google/zimu/firmware/imu2_filtered/README.md

MIMU Firmware
=============

These files contain the source for the TMS320F28335 processor on the MIMU board. This has been tested using Texas Instruments Code Composer Studio v5, and requires DSP/Bios 5.4x.
