google/zimu/hardware/IMU_v2_side/imu_v2_side_SC_BOM.xls

Sample Bill of Materials (BOM) - Customer Provides Materials
Item # | Qty | Ref Des | Part No. | Description | Package | Type | Vendor | status
1 | 1 | C14 | 445-1311-1-ND | 0.01UF | 0603 | SMT | Digikey | 20
2 | 6 | C1, C2, C3, C7, C8, C13 | 490-1519-1-ND | 0.1UF | 0603 | SMT | Digikey | 100
3 | 2 | C4, C6 | 399-1280-1-ND (http://search.digikey.com/scripts/DkSearch/dksus.dll?Detail&itemSeq=105548842&uq=634534378129228834) | 0.022UF | 0603 | SMT | Digikey | 30
4 | 3 | C9, C10, C11 | 490-3290-1-ND | 0.22UF | 0603 | SMT | Digikey | 40
5 | 1 | C5 | 478-1232-1-ND (http://search.digikey.com/scripts/DkSearch/dksus.dll?Detail&itemSeq=105548793&uq=634534378129228834) | 0.027UF | 0603 | SMT | Digikey | 20
6 | 1 | C12 | 587-1253-1-ND | 2.2UF | 0603 | SMT | Digikey | 20
7 | 2 | R8, R9 | TNP4.99KAACT-ND | 4.99K | 0603 | SMT | Digikey | 30
8 | 4 | R2, R3, R5, R7 | P10.0KHCT-ND | 10K | 0603 | SMT | Digikey | 60
9 | 1 | R1 | P226KHCT-ND | 226K | 0603 | SMT | Digikey | 20
10 | 1 | U3 | 1221L-050 | ACCEL_1221 | LCC-20 | BGA | Silicon Designs | 13
11 | 1 | U1 | ADXRS642BBG | ADXRS642BBZG | CBGA32 | BGA | Arrow | 13
12 | 2 | R4, R6 |  | DNL | 0603 | DNS
13 | 1 | S1 |  | HEADER_1X12_IMU |  | DNS
14 | 1 | U2 | 342-1055-1-ND | HMC6042 | LCC-20 | BGA | Digikey | 25
15 | 4 | E1, E2, E3, E4 |  | TP40RND |  | DNS
 |  |  |  | BOARD SUMMARY FOR QUOTE
 |  |  |  | Total # of unique parts | 12
 |  |  |  | SMT placements per board | 21
 |  |  |  | Thru-hole placements per board | 0
 |  |  |  | Fine pitch placements per board | 0
 |  |  |  | BGA placements per board | 3
Screaming Circuits |  |  | Toll-free 866-784-5887 |  |  | 1140 NW Third Ave.
www.ScreamingCircuits.com |  |  | Fax 503-263-9101
A Division of Milwaukee Electronics Inc. |  |  | Email: sales@screamingcircuits.com |  |  | Canby, OR 97013
