google/zimu/hardware/IMU_v2/imu_v2_SC_BOM.xls

Sample Bill of Materials (BOM) - Customer Provides Materials
Item # | Qty | Ref Des | Part No. | Description | Package | Type | Vender | status
1 | 1 | R71 | P0.0GCT-ND | 0 | 0603 | SMT | Digikey | 50
2 | 7 | C29, C77, C113, C117, C122, C127, C131 | 445-1311-1-ND | 0.01UF | 0603 | SMT | Digikey | 50
3 | 53 | C1, C2, C3, C4, C5, C6, C7, C8, C9, C10, C11, C12, C13, C14, C15, C16, C17, C18, C19, C20, C21, C22, C23, C24, C25, C26, C27, C28, C30, C31, C32, C43, C44, C55, C56, C57, C58, C59, C65, C66, C67, C68, C71, C73, C79, C80, C85, C96, C101, C102, C103, C112, C133 | 490-1519-1-ND | 0.1UF | 0603 | SMT | Digikey | 350
4 | 2 | C60, C64 | 399-1280-1-ND (http://search.digikey.com/scripts/DkSearch/dksus.dll?Detail&itemSeq=105548842&uq=634534378129228834) | 0.022UF | 0603 | SMT | Digikey | 20
5 | 12 | C63, C72, C75, C86, C87, C89, C91, C98, C100, C105, C107, C109 | 490-3290-1-ND | 0.22UF | 0603 | SMT | Digikey | 80
6 | 1 | C61 | 478-1232-1-ND (http://search.digikey.com/scripts/DkSearch/dksus.dll?Detail&itemSeq=105548793&uq=634534378129228834) | 0.027UF | 0603 | SMT | Digikey | 10
7 | 9 | C62, C74, C88, C90, C97, C99, C104, C106, C108 | 490-3291-1-ND | 0.47UF | 0603 | SMT | Digikey | 60
8 | 1 | R70 | P1.78KHCT-ND | 1.78K | 0603 | SMT | Digikey | 10
9 | 3 | R9, R10, R69 | P1.00KHCT-ND | 1K | 0603 | SMT | Digikey | 50
10 | 10 | C70, C78, C83, C84, C94, C95, C116, C121, C126, C130 | 490-3897-1-ND | 1UF | 0603 | SMT | Digikey | 70
11 | 2 | C53, C54 | 587-1253-1-ND | 2.2UF | 0603 | SMT | Digikey | 20
12 | 1 | L1 | 445-3215-1-ND | 2.2UH |  | SMT | Digikey | 10
13 | 1 | R68 | P2.80KHCT-ND | 2.8K | 0603 | SMT | Digikey | 10
14 | 2 | R3, R4 | P2.21KHCT-ND | 2.21K | 0603 | SMT | Digikey | 20
15 | 3 | R30, R43, R44 | P2.00KHCT-ND | 2K | 0603 | SMT | Digikey | 20
16 | 1 | L2 | 445-3216-1-ND | 3.3UH |  | SMT | Digikey | 10
17 | 2 | R1, R2 | P4.64KHCT-ND | 4.64K | 0603 | SMT | Digikey | 20
18 | 6 | R14, R47, R49, R53, R55, R57 | P4.87KHCT-ND | 4.87K | 0603 | SMT | Digikey | 50
19 | 4 | R20, R21, R28, R29 | TNP4.99KAACT-ND | 4.99K | 0603 | SMT | Digikey | 30
20 | 6 | R22, R26, R31, R32, R39, R40 | P5.36KHCT-ND | 5.36K | 0603 | SMT | Digikey | 50
21 | 3 | R27, R41, R42 | P6.98KHCT-ND | 6.98K | 0603 | SMT | Digikey | 50
22 | 9 | R15, R25, R35, R38, R48, R50, R54, R56, R58 | P9.53KHCT-ND | 9.53K | 0603 | SMT | Digikey | 100
23 | 5 | R8, R18, R19, R59, R62 | P10.0KHCT-ND | 10K | 0603 | SMT | Digikey | 50
24 | 4 | C120, C124, C125, C129 | 587-1353-1-ND | 10UF | 1201 | SMT | Digikey | 30
25 | 3 | R13, R45, R46 | P12.0KHCT-ND | 12K | 0603 | SMT | Digikey | 50
26 | 1 | R61 | P14.7KHCT-ND | 14.7K | 0603 | SMT | Digikey | 10
27 | 3 | R24, R34, R37 | P16.2KHCT-ND | 16.2K | 0603 | SMT | Digikey | 50
28 | 2 | C33, C34 | 490-1408-1-ND | 16PF | 0603 | SMT | Digikey | 20
29 | 4 | R17, R51, R52, R67 | P20.0KHCT-ND | 20K | 0603 | SMT | Digikey | 50
30 | 1 | R7 | P22.1KHCT-ND | 22.1K | 0603 | SMT | Digikey | 10
31 | 8 | C110, C111, C115, C118, C119, C123, C128, C132 | 490-3889-1-ND | 22UF | 1210 | SMT | Digikey | 50
32 | 1 | C114 | 399-1055-1-ND | 33PF | 0603 | SMT | Digikey | 10
33 | 1 | R63 | P49.9KHCT-ND | 49.9K | 0603 | SMT | Digikey | 10
34 | 1 | R66 | P68.0KHCT-ND | 68K | 0603 | SMT | Digikey | 10
35 | 3 | R5, R6, R72 | P120HCT-ND | 120 | 0603 | SMT | Digikey | 50
36 | 1 | R65 | P147KHCT-ND | 147K | 0603 | SMT | Digikey | 10
37 | 1 | R60 | P220KHCT-ND | 220K | 0603 | SMT | Digikey | 10
38 | 16 | C35, C36, C37, C38, C39, C40, C41, C42, C45, C46, C47, C48, C49, C50, C51, C52 | 399-1066-1-ND | 220PF | 0603 | SMT | Digikey | 100
39 | 1 | R16 | P226KHCT-ND | 226K | 0603 | SMT | Digikey | 10
40 | 2 | R11, R12 | P511HCT-ND | 511 | 0603 | SMT | Digikey | 20
41 | 2 | RN1, RN2 | 741X163560JPCT-ND | 741X163-56R |  | SMT | Digikey | 15
42 | 6 | C69, C76, C81, C82, C92, C93 | 399-3293-1-ND | 1000PF | 0603 | SMT | Digikey | 50
43 | 1 | E1 | 5015KCT-ND | 5015_TESTCLIP |  | SMT | Digikey | 10
44 | 1 | U11 | 1221L-050 | ACCEL_1221 | LCC-20 | BGA | Silicon Designs | 6
45 | 3 | U9, U12, U13 | AD623ARMZ-ND | AD623ARM | MSOP8 | SMT | Digikey | 20
46 | 1 | U7 | ADXRS642BBG | ADXRS642BBZG | CBGA32 | BGA | Arrow | 6
47 | 4 | R23, R33, R36, R64 |  | DNL |  | DNS
48 | 1 | U5 | DS28CM00R-A00+T | DS28CM00 | SOT23-5 | SMT | Maxim IC | 9
49 | 1 | P1 | SQT-110-01-L-D | HEADER_2X10_2MM |  | DNS | Samtec
50 | 2 | P3, P4 | TMM-112-01-T-S-RA | HEADER_12PIN_2MMRA_TH |  | DNS | Samtec
51 | 2 | D1, D2 | 160-1438-1-ND | LED_0603 | 0603 | SMT | Digikey | 20
52 | 1 | U4 | 497-8415-1-ND | LIS3LV02DL | LGA-16 | BGA | Digikey | 7
53 | 2 | REG1, REG4 | LT1962EMS8#PBF-ND | LT1962EMS8 | MSOP8 | SMT | Digikey | 15
54 | 1 | REG3 | LT1962EMS8-3.3#PBF-ND | LT1962EMS8-3.3 | MSOP8 | SMT | Digikey | 8
55 | 1 | REG2 | LT1962EMS8-5#PBF-ND | LT1962EMS8-5 | MSOP8 | SMT | Digikey | 8
56 | 1 | U2 | MAX3079EESD+-ND | MAX3079EESD | SOIC16 | SMT | Digikey | 7
57 | 1 | S1 | MMS-105-01-L-DV | MMS-105-01-L-DV |  | DNS | Samtec
58 | 1 | X1 | 644-1043-1-ND | NX5032GA-30.000000MHZ |  | SMT | Digikey | 8
59 | 5 | U8, U10, U14, U15, U16 | 296-22565-1-ND | OPA4376AIPW | TSSOP16 | SMT | Digikey | 34
60 | 1 | D14 | PSM712 | PSM712 | SOT23-5 | SMT | Future Electronics | 7
61 | 1 | U18 | 296-11654-1-ND | SN65HVD230D | SOIC8 | SMT | Digikey | 7
62 | 1 | U6 | 296-13494-1-ND | SN74LVC2G07 | SOT23-5 | SMT | Digikey | 8
63 | 1 | U3 | TMS320F28335ZJZA | TMS320F28335ZJZ | BGA176 | BGA | Arrow | 10
64 | 10 | E2, E3, E4, E5, E6, E7, E8, E9, E10, E11 |  | TP30 |  | DNS
65 | 1 | U1 | 296-2638-1-ND | TPS3828-33 | SOT23-6 | SMT | Digikey | 8
66 | 1 | U17 | 296-20690-1-ND | TPS62400DRC | QFN10 | BGA | Digikey | 7
 |  |  |  | BOARD SUMMARY FOR QUOTE
 |  |  |  | Total # of unique parts | 61
 |  |  |  | SMT placements per board | 227
 |  |  |  | Thru-hole placements per board | 0
 |  |  |  | Fine pitch placements per board | 0
 |  |  |  | BGA placements per board | 5
Screaming Circuits |  |  | Toll-free 866-784-5887 |  |  | 1140 NW Third Ave.
www.ScreamingCircuits.com |  |  | Fax 503-263-9101
A Division of Milwaukee Electronics Inc. |  |  | Email: sales@screamingcircuits.com |  |  | Canby, OR 97013
