google/zimu/hardware/IMU_v2_module/IMU_v2_module.brd

## EAGLE design hardware/IMU_v2_module/IMU_v2_module.brd (2013-10-02)

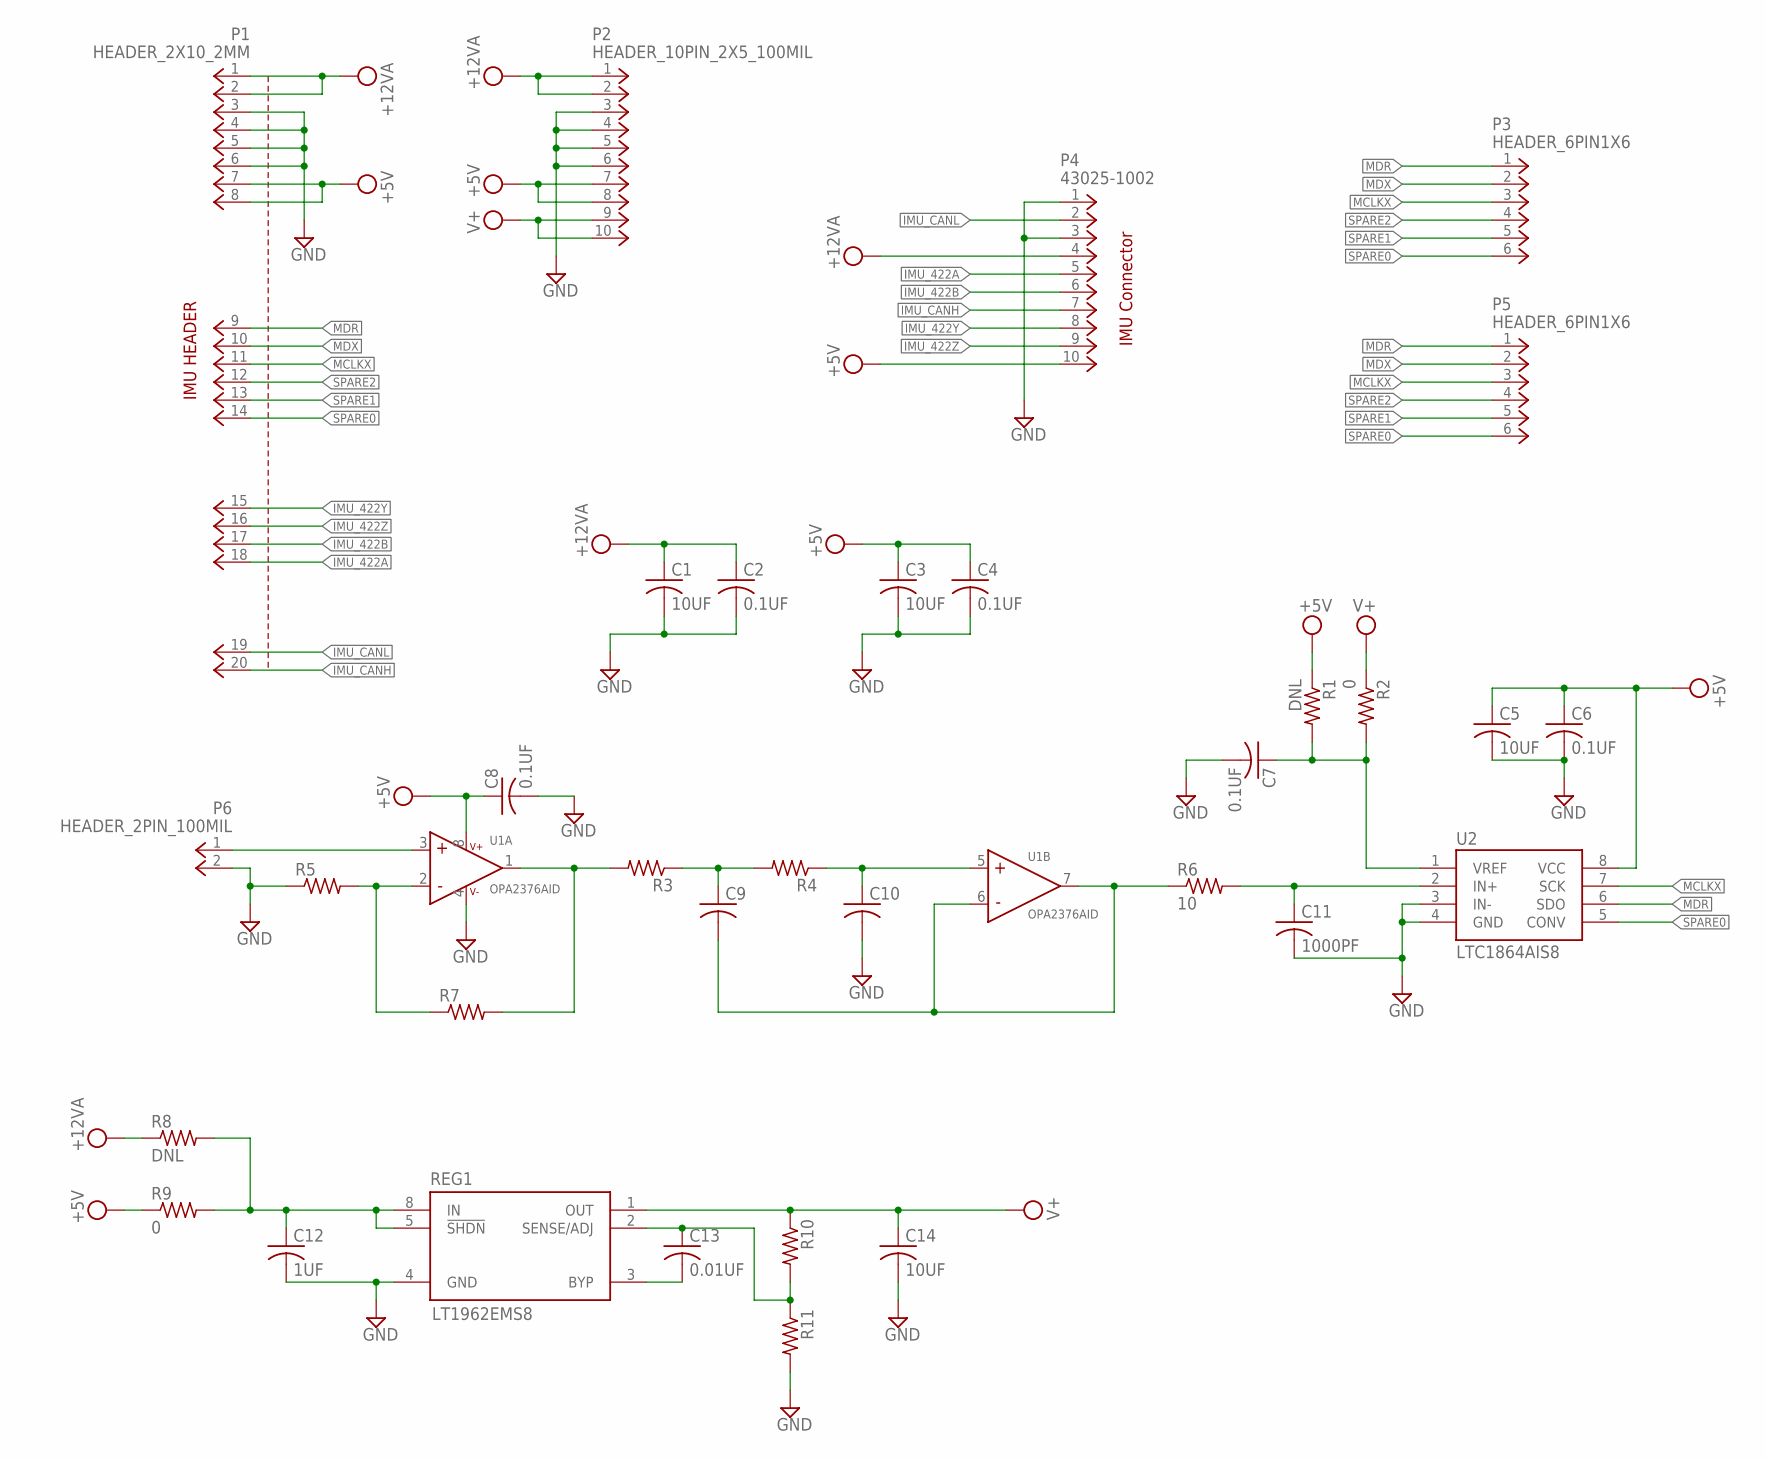
[picture p1: schematic IMU_v2_module.sch]

Parts:
C1, C3, C14: 10UF; C1206K
C2, C4, C6, C7, C8: 0.1UF; C0603K
C5: 10UF; C1206
C9, C10: C0603K
C11: 1000PF; C0603K
C12: 1UF; C0603K
C13: 0.01UF; C0603K
P1: HEADER_2X10_2MM
P2: HEADER_10PIN_2X5_100MIL; HEADER_2X5
P3, P5: HEADER_6PIN1X6; HEADER_1X6
P4: 43025-1002; MICRO-FIT_10RA
P6: HEADER_2PIN_100MIL; HEADER_1X2
R1, R8: DNL; R0603
R2, R9: 0; R0603
R3, R4, R5, R7: R0603
R6: 10; R0603
R10, R11: R-US_R0603; R0603
REG1: LT1962EMS8; MSOP8
U1: OPA2376AID; SOIC8
U2: LTC1864AIS8; SOIC8

Connections:
+5V: C3.1, C4.1, C5.1, C6.1, C8.1, P1.7, P1.8, P2.7, P2.8, P4.10, R1.1, R9.1, U1.8 (V+), U2.8 (VCC)
+12VA: C1.1, C2.1, P1.1, P1.2, P2.1, P2.2, P4.4, R8.1
GND: C1.2, C2.2, C3.2, C4.2, C5.2, C6.2, C7.2, C8.2, C10.2, C11.2, C12.2, C14.2, P1.3, P1.4, P1.5, P1.6, P2.3, P2.4, P2.5, P2.6, P4.1, P4.3, P6.2, R5.1, R11.2, REG1.4 (GND), U1.4 (V-), U2.3 (IN-), U2.4 (GND)
IMU_422A: P1.18, P4.5
IMU_422B: P1.17, P4.6
IMU_422Y: P1.15, P4.8
IMU_422Z: P1.16, P4.9
IMU_CANH: P1.20, P4.7
IMU_CANL: P1.19, P4.2
LC_A: C9.2, R6.1, U1.6 (IN-), U1.7 (OUT)
MCLKX: P1.11, P3.3, P5.3, U2.7 (SCK)
MDR: P1.9, P3.1, P5.1, U2.6 (SDO)
MDX: P1.10, P3.2, P5.2
unnamed: C12.1, R8.2, R9.2, REG1.5 (!SHDN), REG1.8 (IN)
unnamed: C7.1, R1.2, R2.2, U2.1 (VREF)
unnamed: R5.2, R7.1, U1.2 (IN-)
unnamed: P6.1, U1.3 (IN+)
unnamed: R3.2, R7.2, U1.1 (OUT)
unnamed: C11.1, R6.2, U2.2 (IN+)
unnamed: C9.1, R3.1, R4.2
unnamed: C10.1, R4.1, U1.5 (IN+)
unnamed: C13.2, REG1.3 (BYP)
unnamed: C13.1, R10.2, R11.1, REG1.2 (SENSE/ADJ)
SPARE0: P1.14, P3.6, P5.6, U2.5 (CONV)
SPARE1: P1.13, P3.5, P5.5
SPARE2: P1.12, P3.4, P5.4
V+: C14.1, P2.9, P2.10, R2.1, R10.1, REG1.1 (OUT)

Notes on the sheet:
IMU HEADER
IMU Connector

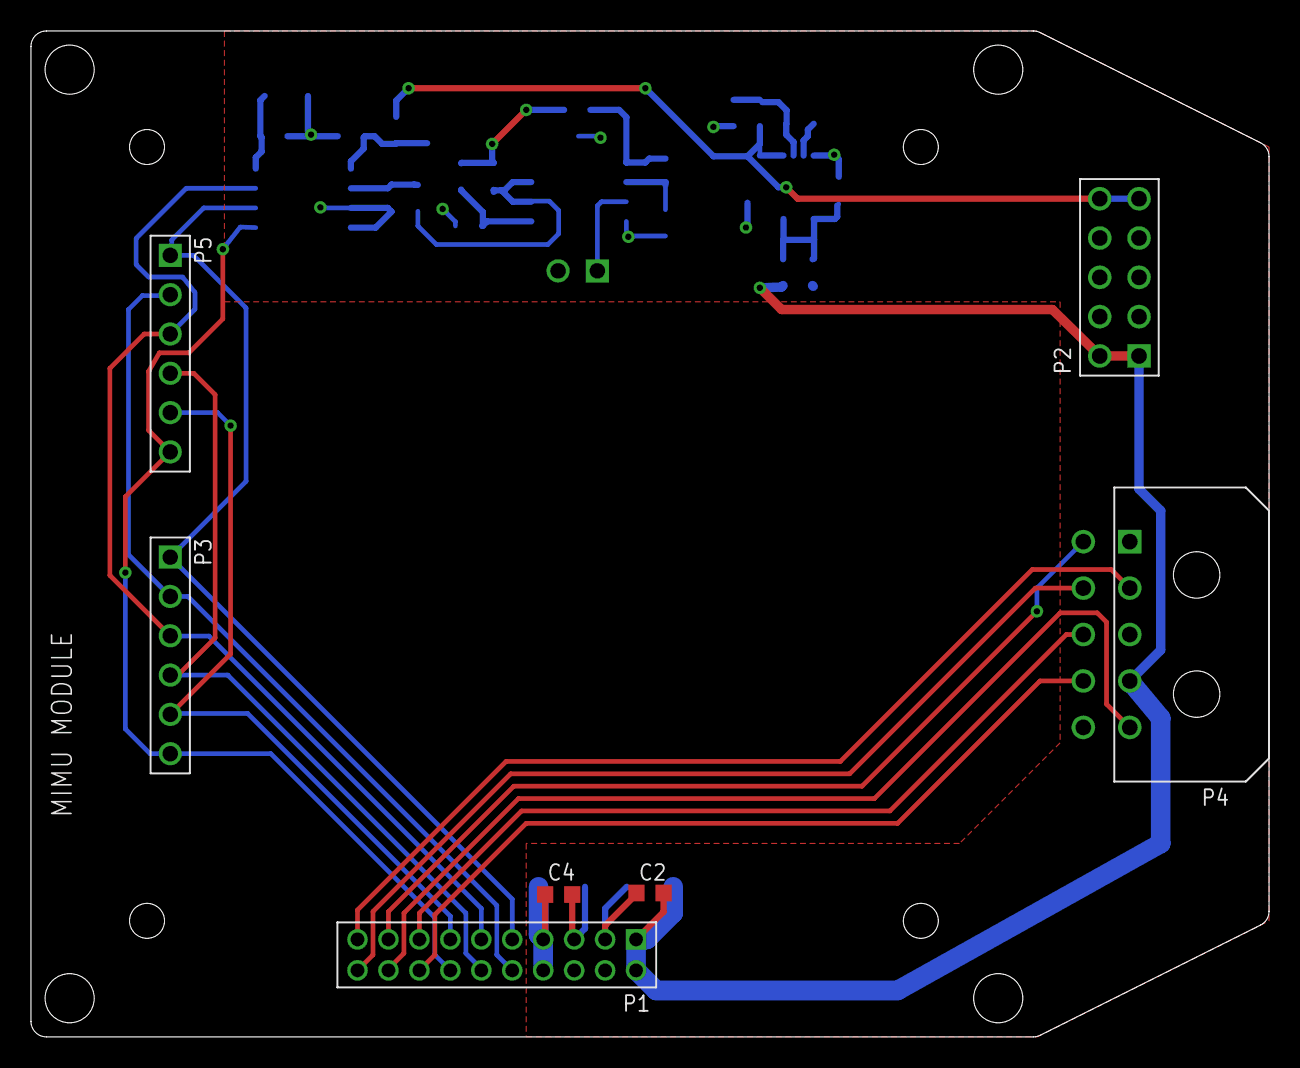
[picture p2: board IMU_v2_module.brd from above]

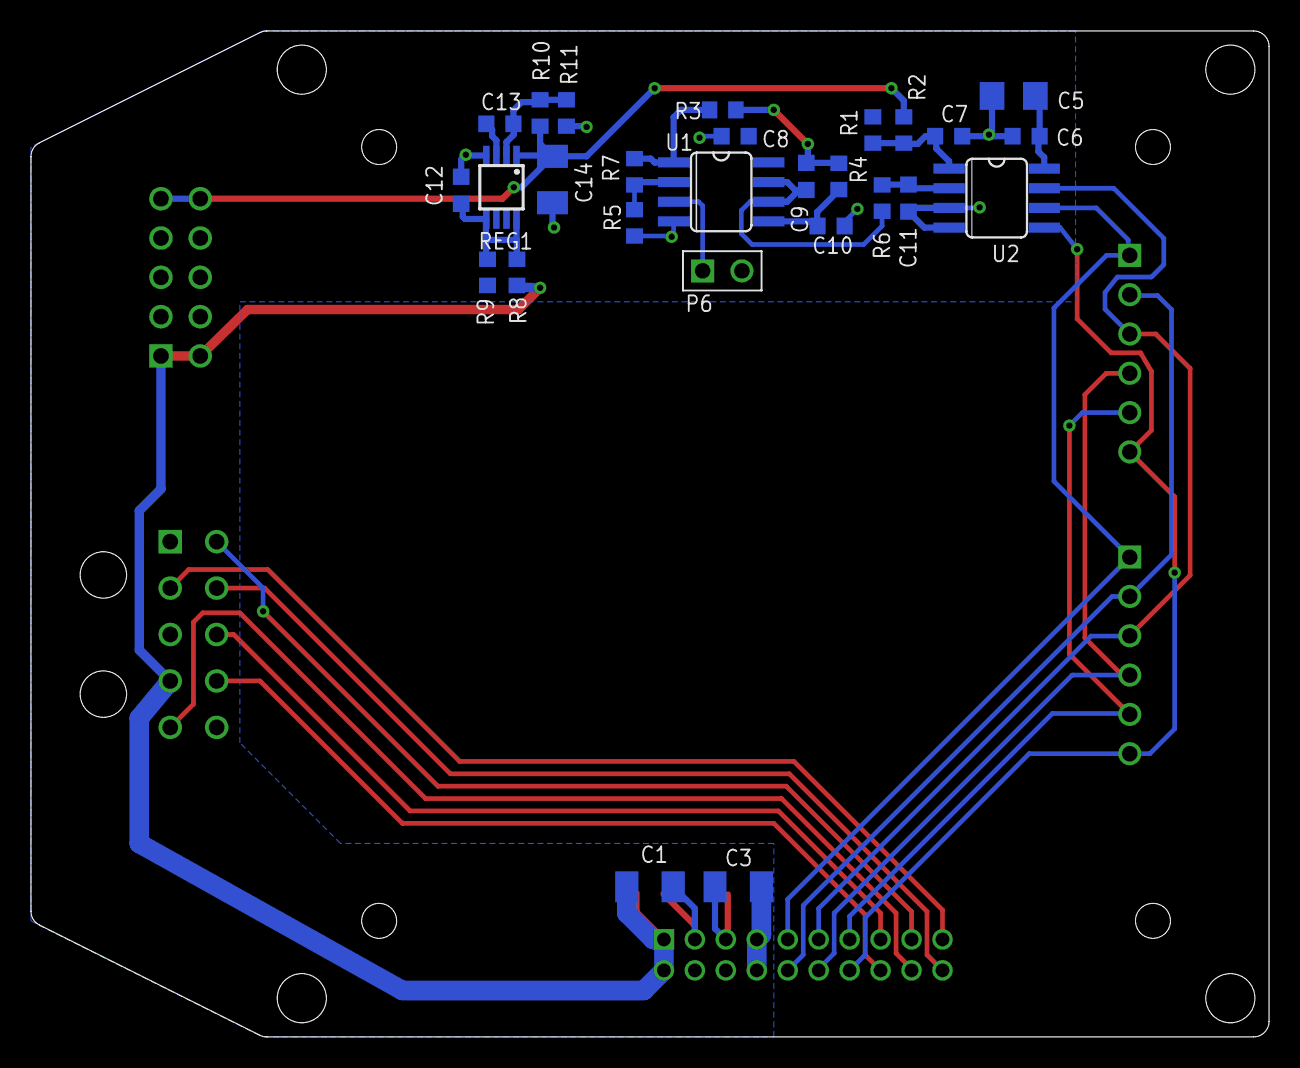
[picture p3: board IMU_v2_module.brd from below]

Board: 2 copper layers, 80.0 x 65.0 mm, 34 parts (27 on the bottom side), 27 nets.
