google/zimu/hardware/IMU_v2/imu_v2.brd

## EAGLE design hardware/IMU_v2/imu_v2.brd (2013-10-02)

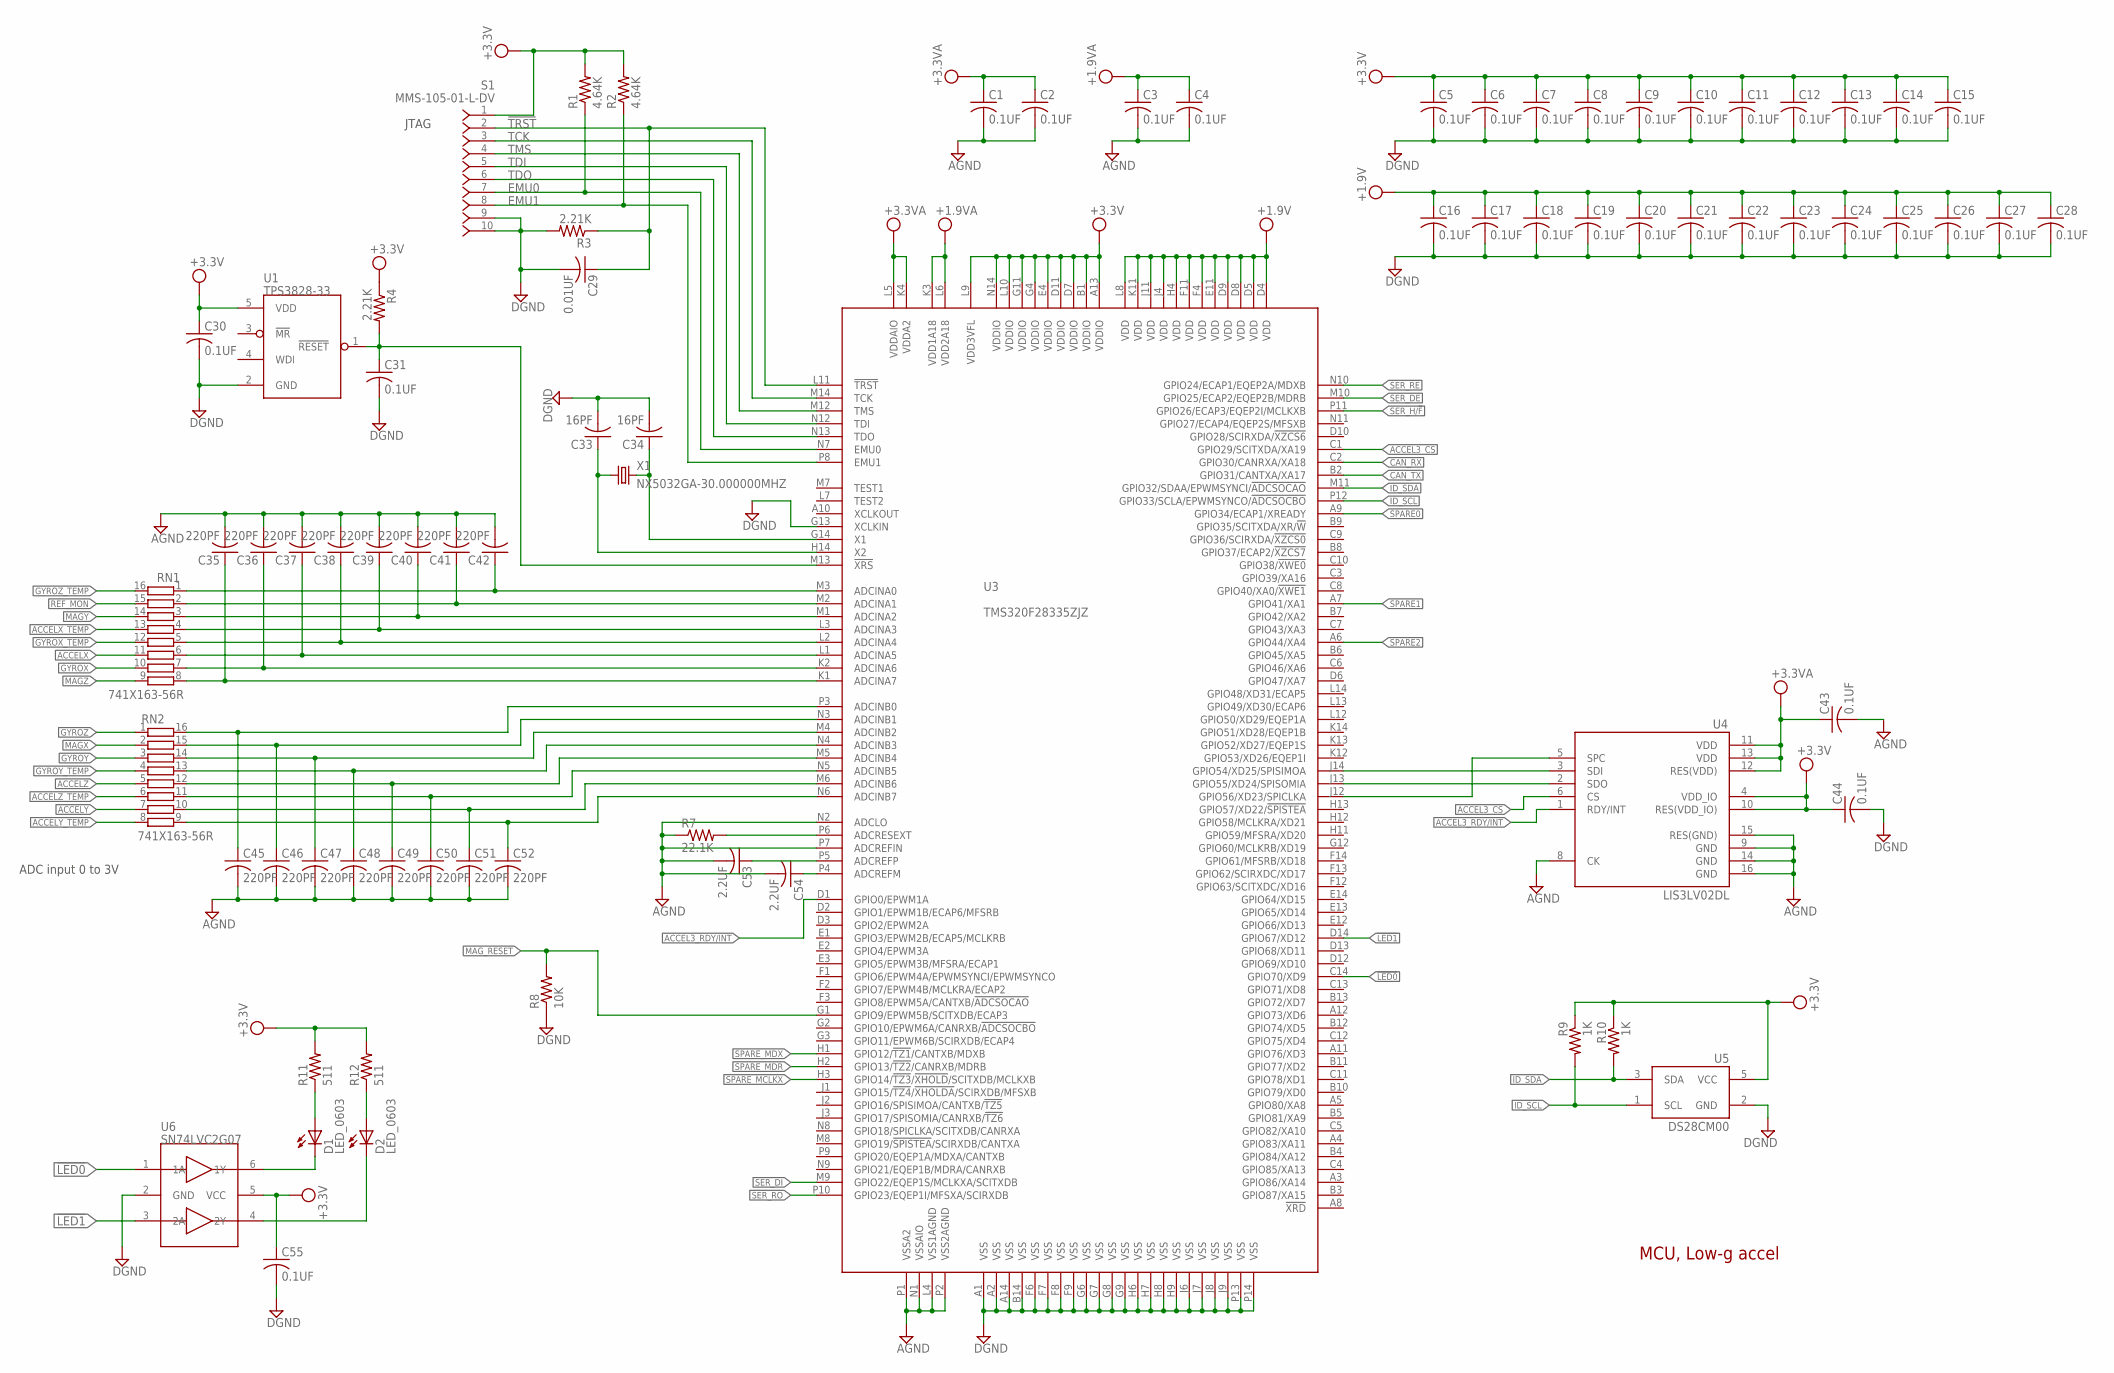
[picture p4: schematic imu_v2.sch, sheet 1]

Parts:
C1, C2, C3, C4, C5, C6, C7, C8, C9, C10, C11, C12, C13, C14, C15, C16, C17, C18, C19, C20, C21, C22, C23, C24, C25, C26, C27, C28, C30, C31, C43, C44, C55: 0.1UF; C0603K
C29: 0.01UF; C0603K
C33, C34: 16PF; C0603K
C35, C36, C37, C38, C39, C40, C41, C42, C45, C46, C47, C48, C49, C50, C51, C52: 220PF; C0603K
C53, C54: 2.2UF; C0603K
D1, D2: LED_0603
R1, R2: 4.64K; R0603
R3, R4: 2.21K; R0603
R7: 22.1K; R0603
R8: 10K; R0603
R9, R10: 1K; R0603
R11, R12: 511; R0603
RN1, RN2: 741X163-56R; 741X163
S1: MMS-105-01-L-DV; HEADER_2X5_2MM_TH
U1: TPS3828-33; SOT23-5
U3: TMS320F28335ZJZ; ZJZ_PBGA176
U4: LIS3LV02DL; LIS3LV02DL_LGA16
U5: DS28CM00; SOT23-5L
U6: SN74LVC2G07; SOT23-6
X1: NX5032GA-30.000000MHZ; NX5032GA

Connections:
!LED0: U3.C14 (GPIO70/XD9), U6.1 (1A)
!LED1: U3.D14 (GPIO67/XD12), U6.3 (2A)
!TRST: C29.1, R3.1, S1.2 (1), U3.L11 (!TRST!)
+1.9V: C16.1, C17.1, C18.1, C19.1, C20.1, C21.1, C22.1, C23.1, C24.1, C25.1, C26.1, C27.1, C28.1, U3.D4 (VDD), U3.D5 (VDD), U3.D8 (VDD), U3.D9 (VDD), U3.E11 (VDD), U3.F4 (VDD), U3.F11 (VDD), U3.H4 (VDD), U3.J4 (VDD), U3.J11 (VDD), U3.K11 (VDD), U3.L8 (VDD); also elsewhere on the board
+1.9VA: C3.1, C4.1, U3.K3 (VDD1A18), U3.L6 (VDD2A18); also elsewhere on the board
+3.3V: C5.1, C6.1, C7.1, C8.1, C9.1, C10.1, C11.1, C12.1, C13.1, C14.1, C15.1, C30.1, C44.1, C55.1, R1.2, R2.2, R4.1, R9.1, R10.1, R11.2, R12.2, S1.1, U1.5 (VDD), U3.A13 (VDDIO), U3.B1 (VDDIO), U3.D7 (VDDIO), U3.D11 (VDDIO), U3.E4 (VDDIO), U3.G4 (VDDIO), U3.G11 (VDDIO), U3.L9 (VDD3VFL), U3.L10 (VDDIO), U3.N14 (VDDIO), U4.4 (VDD_IO), U4.10 (RES(VDD_IO)), U5.5 (VCC), U6.5 (VCC); also elsewhere on the board
+3.3VA: C1.1, C2.1, C43.1, U3.K4 (VDDA2), U3.L5 (VDDAIO), U4.11 (VDD), U4.12 (RES(VDD)), U4.13 (VDD); also elsewhere on the board
ACCEL3_CLK: U3.J12 (GPIO56/XD23/SPICLKA), U4.5 (SPC)
ACCEL3_CS: U3.C1 (GPIO29/SCITXDA/XA19), U4.6 (CS)
ACCEL3_RDY/INT: U3.D1 (GPIO0/EPWM1A), U4.1 (RDY/INT)
ACCEL3_SIMO: U3.J14 (GPIO54/XD25/SPISIMOA), U4.3 (SDI)
ACCEL3_SOMI: U3.J13 (GPIO55/XD24/SPISOMIA), U4.2 (SDO)
ACCELX: RN1.11; also elsewhere on the board
ACCELX_TEMP: RN1.13; also elsewhere on the board
ACCELY: RN2.7; also elsewhere on the board
ACCELY_TEMP: RN2.8; also elsewhere on the board
ACCELZ: RN2.5; also elsewhere on the board
ACCELZ_TEMP: RN2.6; also elsewhere on the board
AGND: C1.2, C2.2, C3.2, C4.2, C35.2, C36.2, C37.2, C38.2, C39.2, C40.2, C41.2, C42.2, C43.2, C45.2, C46.2, C47.2, C48.2, C49.2, C50.2, C51.2, C52.2, C53.2, C54.2, R7.1, U3.L4 (VSS1AGND), U3.N1 (VSSAIO), U3.N2 (ADCLO), U3.P1 (VSSA2), U3.P2 (VSS2AGND), U3.P7 (ADCREFIN), U4.8 (CK), U4.9 (GND), U4.14 (GND), U4.15 (RES(GND)), U4.16 (GND); also elsewhere on the board
CAN_RX: U3.C2 (GPIO30/CANRXA/XA18); also elsewhere on the board
CAN_TX: U3.B2 (GPIO31/CANTXA/XA17); also elsewhere on the board
DGND: C5.2, C6.2, C7.2, C8.2, C9.2, C10.2, C11.2, C12.2, C13.2, C14.2, C15.2, C16.2, C17.2, C18.2, C19.2, C20.2, C21.2, C22.2, C23.2, C24.2, C25.2, C26.2, C27.2, C28.2, C29.2, C30.2, C31.2, C33.2, C34.2, C44.2, C55.2, R3.2, R8.1, S1.9 (1), S1.10 (1), U1.2 (GND), U3.A1 (VSS), U3.A2 (VSS), U3.A14 (VSS), U3.B14 (VSS), U3.F6 (VSS), U3.F7 (VSS), U3.F8 (VSS), U3.F9 (VSS), U3.G6 (VSS), U3.G7 (VSS), U3.G8 (VSS), U3.G9 (VSS), U3.G13 (XCLKIN), U3.H6 (VSS), U3.H7 (VSS), U3.H8 (VSS), U3.H9 (VSS), U3.J6 (VSS), U3.J7 (VSS), U3.J8 (VSS), U3.J9 (VSS), U3.P13 (VSS), U3.P14 (VSS), U5.2 (GND), U6.2 (GND); also elsewhere on the board
EMU0: R1.1, S1.7 (1), U3.N7 (EMU0)
EMU1: R2.1, S1.8 (1), U3.P8 (EMU1)
GYROX: RN1.10; also elsewhere on the board
GYROX_TEMP: RN1.12; also elsewhere on the board
GYROY: RN2.3; also elsewhere on the board
GYROY_TEMP: RN2.4; also elsewhere on the board
GYROZ: RN2.1; also elsewhere on the board
GYROZ_TEMP: RN1.16; also elsewhere on the board
ID_SCL: R9.2, U3.P12 (GPIO33/SCLA/EPWMSYNCO/!ADCSOCBO!), U5.1 (SCL)
ID_SDA: R10.2, U3.M11 (GPIO32/SDAA/EPWMSYNCI/!ADCSOCAO!), U5.3 (SDA)
MAGX: RN2.2; also elsewhere on the board
MAGY: RN1.14; also elsewhere on the board
MAGZ: RN1.9; also elsewhere on the board
MAG_RESET: R8.2, U3.G1 (GPIO9/EPWM5B/SCITXDB/ECAP3); also elsewhere on the board
unnamed: C42.1, RN1.1, U3.M3 (ADCINA0)
unnamed: C41.1, RN1.2, U3.M2 (ADCINA1)
unnamed: C40.1, RN1.3, U3.M1 (ADCINA2)
unnamed: C39.1, RN1.4, U3.L3 (ADCINA3)
unnamed: C38.1, RN1.5, U3.L2 (ADCINA4)
unnamed: C37.1, RN1.6, U3.L1 (ADCINA5)
unnamed: C36.1, RN1.7, U3.K2 (ADCINA6)
unnamed: C35.1, RN1.8, U3.K1 (ADCINA7)
unnamed: C45.1, RN2.16, U3.P3 (ADCINB0)
unnamed: C46.1, RN2.15, U3.N3 (ADCINB1)
unnamed: C47.1, RN2.14, U3.M4 (ADCINB2)
unnamed: C48.1, RN2.13, U3.N4 (ADCINB3)
unnamed: C49.1, RN2.12, U3.M5 (ADCINB4)
unnamed: C50.1, RN2.11, U3.N5 (ADCINB5)
unnamed: C51.1, RN2.10, U3.M6 (ADCINB6)
unnamed: C52.1, RN2.9, U3.N6 (ADCINB7)
unnamed: C31.1, R4.2, U1.1 (!RESET), U3.M13 (!XRS!)
unnamed: C33.1, U3.H14 (X2), X1.1
unnamed: C34.1, U3.G14 (X1), X1.2
unnamed: R7.2, U3.P6 (ADCRESEXT)
unnamed: C54.1, U3.P4 (ADCREFM)
unnamed: C53.1, U3.P5 (ADCREFP)
unnamed: D1.A, R11.1
unnamed: D2.A, R12.1
unnamed: D1.C, U6.6 (1Y)
unnamed: D2.C, U6.4 (2Y)
REF_MON: RN1.15; also elsewhere on the board
SER_!RE: U3.N10 (GPIO24/ECAP1/EQEP2A/MDXB); also elsewhere on the board
SER_DE: U3.M10 (GPIO25/ECAP2/EQEP2B/MDRB); also elsewhere on the board
SER_DI: U3.M9 (GPIO22/EQEP1S/MCLKXA/SCITXDB); also elsewhere on the board
SER_H/!F: U3.P11 (GPIO26/ECAP3/EQEP2I/MCLKXB); also elsewhere on the board
SER_RO: U3.P10 (GPIO23/EQEP1I/MFSXA/SCIRXDB); also elsewhere on the board
SPARE0: U3.A9 (GPIO34/ECAP1/XREADY); also elsewhere on the board
SPARE1: U3.A7 (GPIO41/XA1); also elsewhere on the board
SPARE2: U3.A6 (GPIO44/XA4); also elsewhere on the board
SPARE_MCLKX: U3.H3 (GPIO14/!TZ3!/!XHOLD!/SCITXDB/MCLKXB); also elsewhere on the board
SPARE_MDR: U3.H2 (GPIO13/!TZ2!/CANRXB/MDRB); also elsewhere on the board
SPARE_MDX: U3.H1 (GPIO12/!TZ1!/CANTXB/MDXB); also elsewhere on the board
TCK: S1.3 (1), U3.M14 (TCK)
TDI: S1.5 (1), U3.N12 (TDI)
TDO: S1.6 (1), U3.N13 (TDO)
TMS: S1.4 (1), U3.M12 (TMS)

Notes on the sheet:
JTAG
MCU, Low-g accel
ADC input 0 to 3V

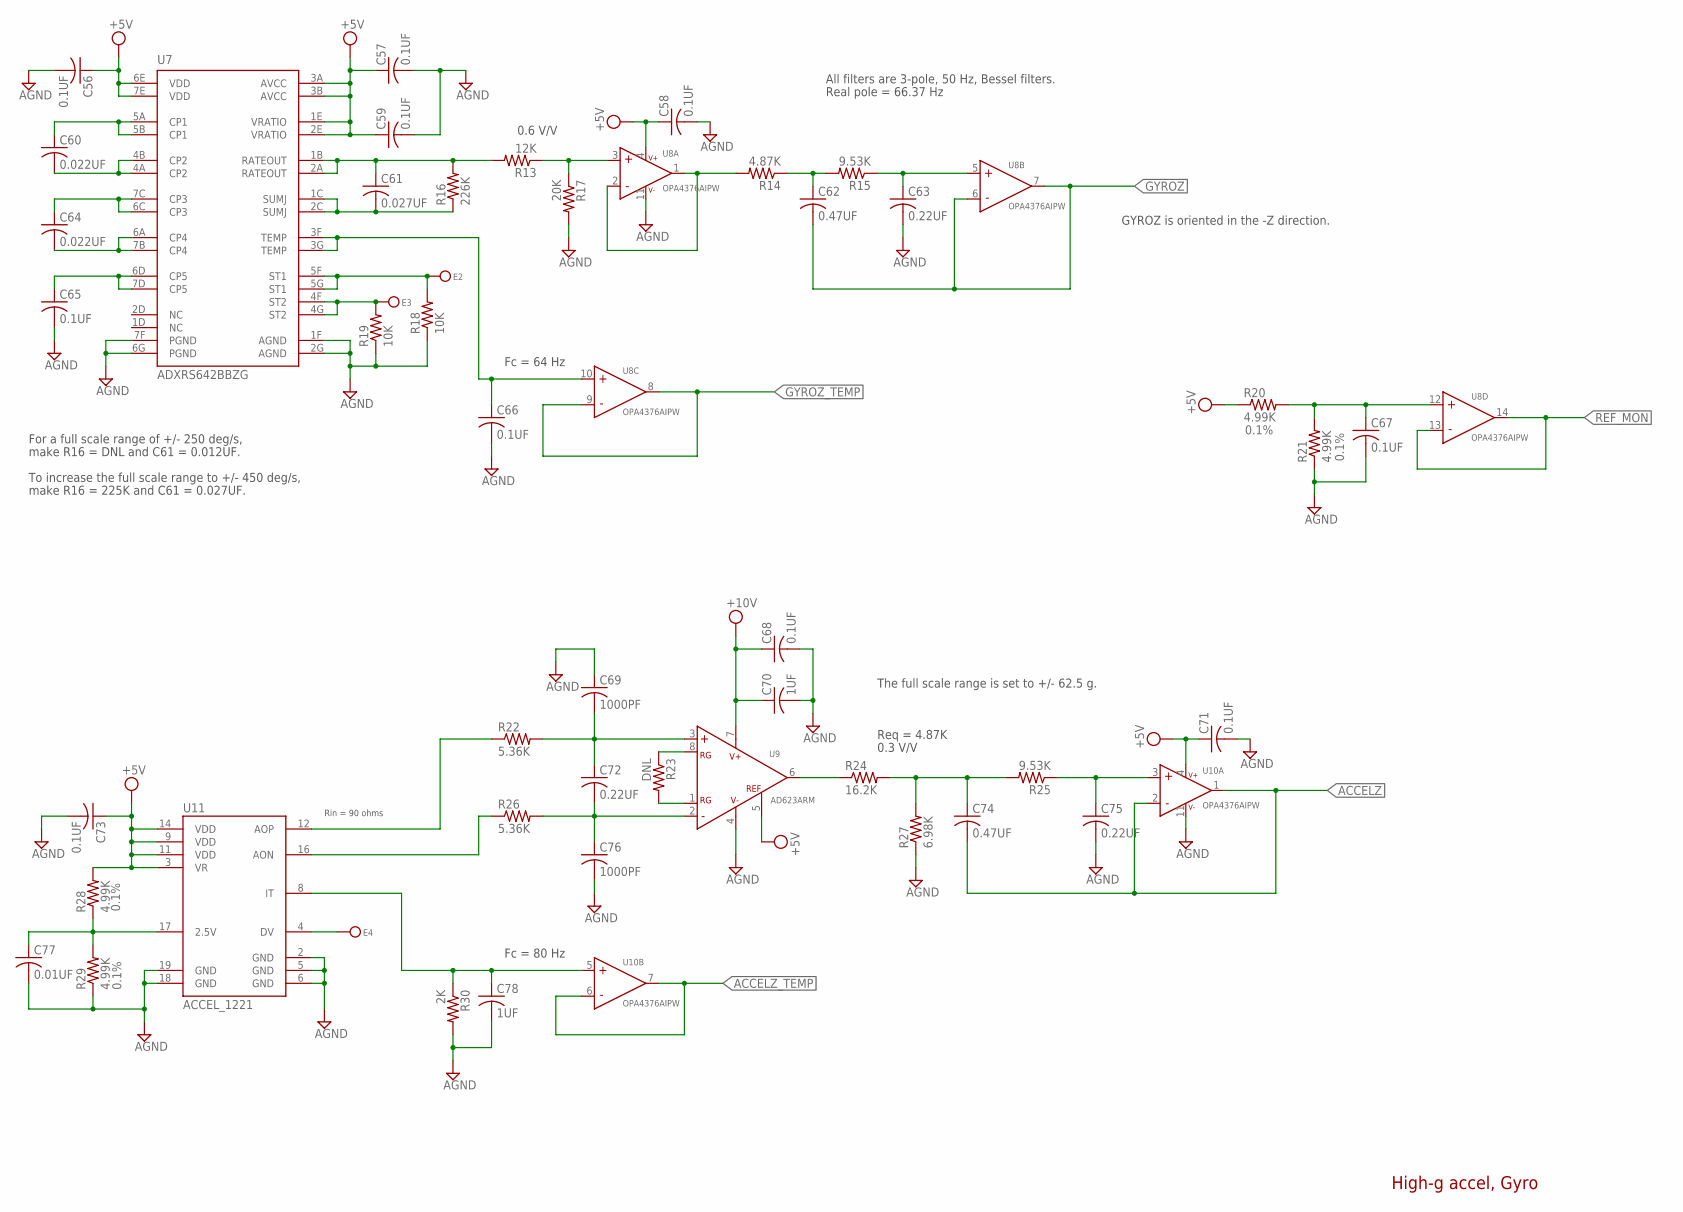
[picture p5: schematic imu_v2.sch, sheet 2]

Parts:
C56, C57, C58, C59, C65, C66, C67, C68, C71, C73: 0.1UF; C0603K
C60, C64: 0.022UF; C0603K
C61: 0.027UF; C0603K
C62, C74: 0.47UF; C0603K
C63, C72, C75: 0.22UF; C0603K
C69, C76: 1000PF; C0603K
C70, C78: 1UF; C0603K
C77: 0.01UF; C0603K
E2, E3, E4: TP30
R13: 12K; R0603
R14: 4.87K; R0603
R15, R25: 9.53K; R0603
R16: 226K; R0603
R17: 20K; R0603
R18, R19: 10K; R0603
R20, R21, R28, R29: 4.99K; R0603
R22, R26: 5.36K; R0603
R23: DNL; R0603
R24: 16.2K; R0603
R27: 6.98K; R0603
R30: 2K; R0603
U7: ADXRS642BBZG; ADXRS_CBGA32
U8, U10: OPA4376AIPW; TSSOP14
U9: AD623ARM; MSOP8
U11: ACCEL_1221; 1221_LCC

Connections:
+5V: C56.1, C57.1, C58.1, C59.1, C71.1, C73.1, R20.1, R28.2, U7.1E (VRATIO), U7.2E (VRATIO), U7.3A (AVCC), U7.3B (AVCC), U7.6E (VDD), U7.7E (VDD), U8.4 (V+), U9.5 (REF), U10.4 (V+), U11.3 (VR), U11.9 (VDD), U11.11 (VDD), U11.14 (VDD); also elsewhere on the board
+10V: C68.1, C70.1, U9.7 (VS+); also elsewhere on the board
ACCELZ: C74.2, U10.1 (OUT), U10.2 (IN-); also elsewhere on the board
ACCELZ_TEMP: U10.6 (IN-), U10.7 (OUT); also elsewhere on the board
AGND: C56.2, C57.2, C58.2, C59.2, C63.2, C65.2, C66.2, C67.2, C68.2, C69.1, C70.2, C71.2, C73.2, C75.2, C76.2, C77.2, C78.2, R17.2, R18.1, R19.1, R21.1, R27.1, R29.1, R30.2, U7.1F (AGND), U7.2G (AGND), U7.6G (PGND), U7.7F (PGND), U8.11 (V-), U9.4 (VS-), U10.11 (V-), U11.2 (GND), U11.5 (GND), U11.6 (GND), U11.18 (GND), U11.19 (GND); also elsewhere on the board
GYROZ: C62.2, U8.6 (IN-), U8.7 (OUT); also elsewhere on the board
GYROZ_TEMP: U8.8 (OUT), U8.9 (IN-); also elsewhere on the board
unnamed: C60.1, U7.5A (CP1), U7.5B (CP1)
unnamed: C60.2, U7.4A (CP2), U7.4B (CP2)
unnamed: C64.1, U7.6C (CP3), U7.7C (CP3)
unnamed: C64.2, U7.6A (CP4), U7.7B (CP4)
unnamed: C65.1, U7.6D (CP5), U7.7D (CP5)
unnamed: C77.1, R28.1, R29.2, U11.17 (2.5V)
unnamed: C61.2, R16.1, U7.1C (SUMJ), U7.2C (SUMJ)
unnamed: E4.1, U11.4 (DV)
unnamed: C61.1, R13.2, R16.2, U7.1B (RATEOUT), U7.2A (RATEOUT)
unnamed: C66.1, U7.3F (TEMP), U7.3G (TEMP), U8.10 (IN+)
unnamed: C78.1, R30.1, U10.5 (IN+), U11.8 (IT)
unnamed: R22.1, U11.12 (AOP)
unnamed: R26.1, U11.16 (AON)
unnamed: R13.1, R17.1, U8.3 (IN+)
unnamed: R14.2, U8.1 (OUT), U8.2 (IN-)
unnamed: C62.1, R14.1, R15.2
unnamed: C63.1, R15.1, U8.5 (IN+)
unnamed: C69.2, C72.1, R22.2, U9.3 (IN+)
unnamed: C72.2, C76.1, R26.2, U9.2 (IN-)
unnamed: C67.1, R20.2, R21.2, U8.12 (IN+)
unnamed: R23.1, U9.8 (RG)
unnamed: R23.2, U9.1 (RG)
unnamed: R24.1, U9.6 (VOUT)
unnamed: C74.1, R24.2, R25.2, R27.2
unnamed: C75.1, R25.1, U10.3 (IN+)
unnamed: E2.1, R18.2, U7.5F (ST1), U7.5G (ST1)
unnamed: E3.1, R19.2, U7.4F (ST2), U7.4G (ST2)
REF_MON: U8.13 (IN-), U8.14 (OUT); also elsewhere on the board

Notes on the sheet:
0.3 V/V
Rin = 90 ohms
All filters are 3-pole, 50 Hz, Bessel filters.
Real pole = 66.37 Hz
Fc = 64 Hz
0.6 V/V
Req = 4.87K
Fc = 80 Hz
The full scale range is set to +/- 62.5 g.
GYROZ is oriented in the -Z direction.
For a full scale range of +/- 250 deg/s,
make R16 = DNL and C61 = 0.012UF.
make R16 = 225K and C61 = 0.027UF.
To increase the full scale range to +/- 450 deg/s,
High-g accel, Gyro

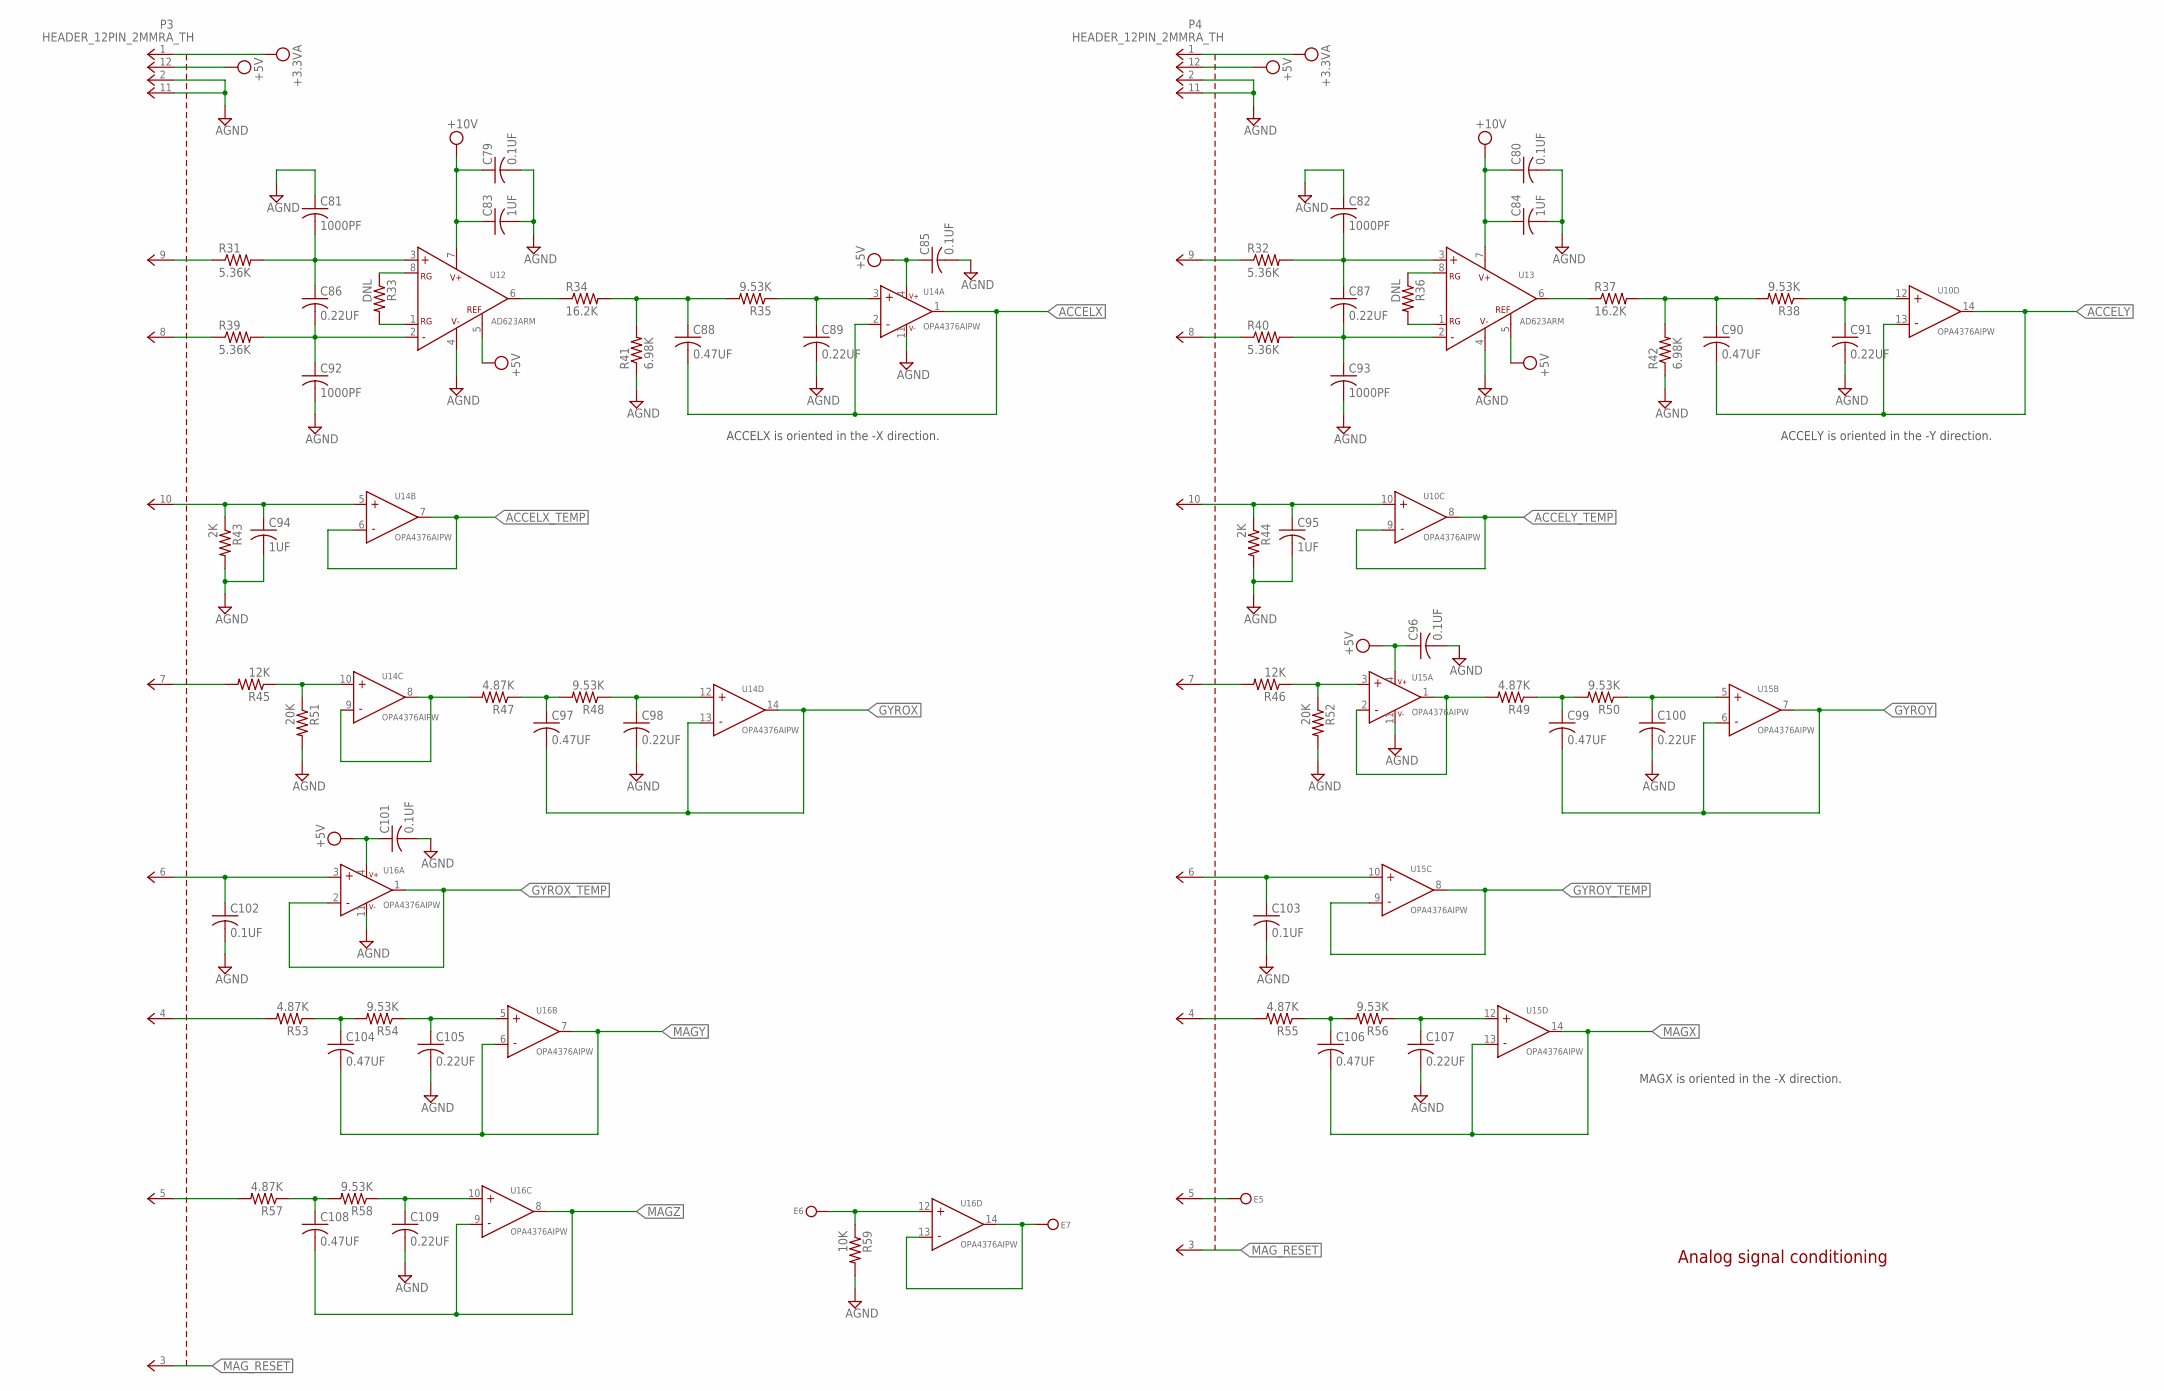
[picture p6: schematic imu_v2.sch, sheet 3]

Parts:
C79, C80, C85, C96, C101, C102, C103: 0.1UF; C0603K
C81, C82, C92, C93: 1000PF; C0603K
C83, C84, C94, C95: 1UF; C0603K
C86, C87, C89, C91, C98, C100, C105, C107, C109: 0.22UF; C0603K
C88, C90, C97, C99, C104, C106, C108: 0.47UF; C0603K
E5, E6, E7: TP30
P3, P4: HEADER_12PIN_2MMRA_TH; TMM-112-01-T-S-RA
R31, R32, R39, R40: 5.36K; R0603
R33, R36: DNL; R0603
R34, R37: 16.2K; R0603
R35, R38, R48, R50, R54, R56, R58: 9.53K; R0603
R41, R42: 6.98K; R0603
R43, R44: 2K; R0603
R45, R46: 12K; R0603
R47, R49, R53, R55, R57: 4.87K; R0603
R51, R52: 20K; R0603
R59: 10K; R0603
U10, U14, U15, U16: OPA4376AIPW; TSSOP14
U12, U13: AD623ARM; MSOP8

Connections:
+3.3VA: P3.1, P4.1; also elsewhere on the board
+5V: C85.1, C96.1, C101.1, P3.12, P4.12, U12.5 (REF), U13.5 (REF), U14.4 (V+), U15.4 (V+), U16.4 (V+); also elsewhere on the board
+10V: C79.1, C80.1, C83.1, C84.1, U12.7 (VS+), U13.7 (VS+); also elsewhere on the board
ACCELX: C88.2, U14.1 (OUT), U14.2 (IN-); also elsewhere on the board
ACCELX_TEMP: U14.6 (IN-), U14.7 (OUT); also elsewhere on the board
ACCELY: C90.2, U10.13 (IN-), U10.14 (OUT); also elsewhere on the board
ACCELY_TEMP: U10.8 (OUT), U10.9 (IN-); also elsewhere on the board
AGND: C79.2, C80.2, C81.1, C82.1, C83.2, C84.2, C85.2, C89.2, C91.2, C92.2, C93.2, C94.2, C95.2, C96.2, C98.2, C100.2, C101.2, C102.2, C103.2, C105.2, C107.2, C109.2, P3.2, P3.11, P4.2, P4.11, R41.1, R42.1, R43.2, R44.2, R51.2, R52.2, R59.2, U12.4 (VS-), U13.4 (VS-), U14.11 (V-), U15.11 (V-), U16.11 (V-); also elsewhere on the board
GYROX: C97.2, U14.13 (IN-), U14.14 (OUT); also elsewhere on the board
GYROX_TEMP: U16.1 (OUT), U16.2 (IN-); also elsewhere on the board
GYROY: C99.2, U15.6 (IN-), U15.7 (OUT); also elsewhere on the board
GYROY_TEMP: U15.8 (OUT), U15.9 (IN-); also elsewhere on the board
MAGX: C106.2, U15.13 (IN-), U15.14 (OUT); also elsewhere on the board
MAGY: C104.2, U16.6 (IN-), U16.7 (OUT); also elsewhere on the board
MAGZ: C108.2, U16.8 (OUT), U16.9 (IN-); also elsewhere on the board
MAG_RESET: P3.3, P4.3; also elsewhere on the board
unnamed: E7.1, U16.13 (IN-), U16.14 (OUT)
unnamed: E6.1, R59.1, U16.12 (IN+)
unnamed: E5.1, P4.5
unnamed: P3.7, R45.2
unnamed: R45.1, R51.1, U14.10 (IN+)
unnamed: R47.2, U14.8 (OUT), U14.9 (IN-)
unnamed: C97.1, R47.1, R48.2
unnamed: C98.1, R48.1, U14.12 (IN+)
unnamed: P4.7, R46.2
unnamed: R46.1, R52.1, U15.3 (IN+)
unnamed: R49.2, U15.1 (OUT), U15.2 (IN-)
unnamed: C99.1, R49.1, R50.2
unnamed: C100.1, R50.1, U15.5 (IN+)
unnamed: C103.1, P4.6, U15.10 (IN+)
unnamed: C102.1, P3.6, U16.3 (IN+)
unnamed: C95.1, P4.10, R44.1, U10.10 (IN+)
unnamed: P3.4, R53.2
unnamed: P4.9, R32.1
unnamed: C82.2, C87.1, R32.2, U13.3 (IN+)
unnamed: C87.2, C93.1, R40.2, U13.2 (IN-)
unnamed: R36.1, U13.8 (RG)
unnamed: R36.2, U13.1 (RG)
unnamed: R37.1, U13.6 (VOUT)
unnamed: C90.1, R37.2, R38.2, R42.2
unnamed: C91.1, R38.1, U10.12 (IN+)
unnamed: C94.1, P3.10, R43.1, U14.5 (IN+)
unnamed: P3.9, R31.1
unnamed: P3.8, R39.1
unnamed: C81.2, C86.1, R31.2, U12.3 (IN+)
unnamed: C86.2, C92.1, R39.2, U12.2 (IN-)
unnamed: R33.1, U12.8 (RG)
unnamed: R33.2, U12.1 (RG)
unnamed: R34.1, U12.6 (VOUT)
unnamed: C88.1, R34.2, R35.2, R41.2
unnamed: C89.1, R35.1, U14.3 (IN+)
unnamed: P4.8, R40.1
unnamed: C104.1, R53.1, R54.2
unnamed: C105.1, R54.1, U16.5 (IN+)
unnamed: P3.5, R57.2
unnamed: C108.1, R57.1, R58.2
unnamed: C109.1, R58.1, U16.10 (IN+)
unnamed: P4.4, R55.2
unnamed: C106.1, R55.1, R56.2
unnamed: C107.1, R56.1, U15.12 (IN+)

Notes on the sheet:
MAGX is oriented in the -X direction.
ACCELX is oriented in the -X direction.
ACCELY is oriented in the -Y direction.
Analog signal conditioning
