google/zimu/hardware/IMU_v2/imu_v2.brd

## EAGLE design hardware/IMU_v2/imu_v2.brd (continued)

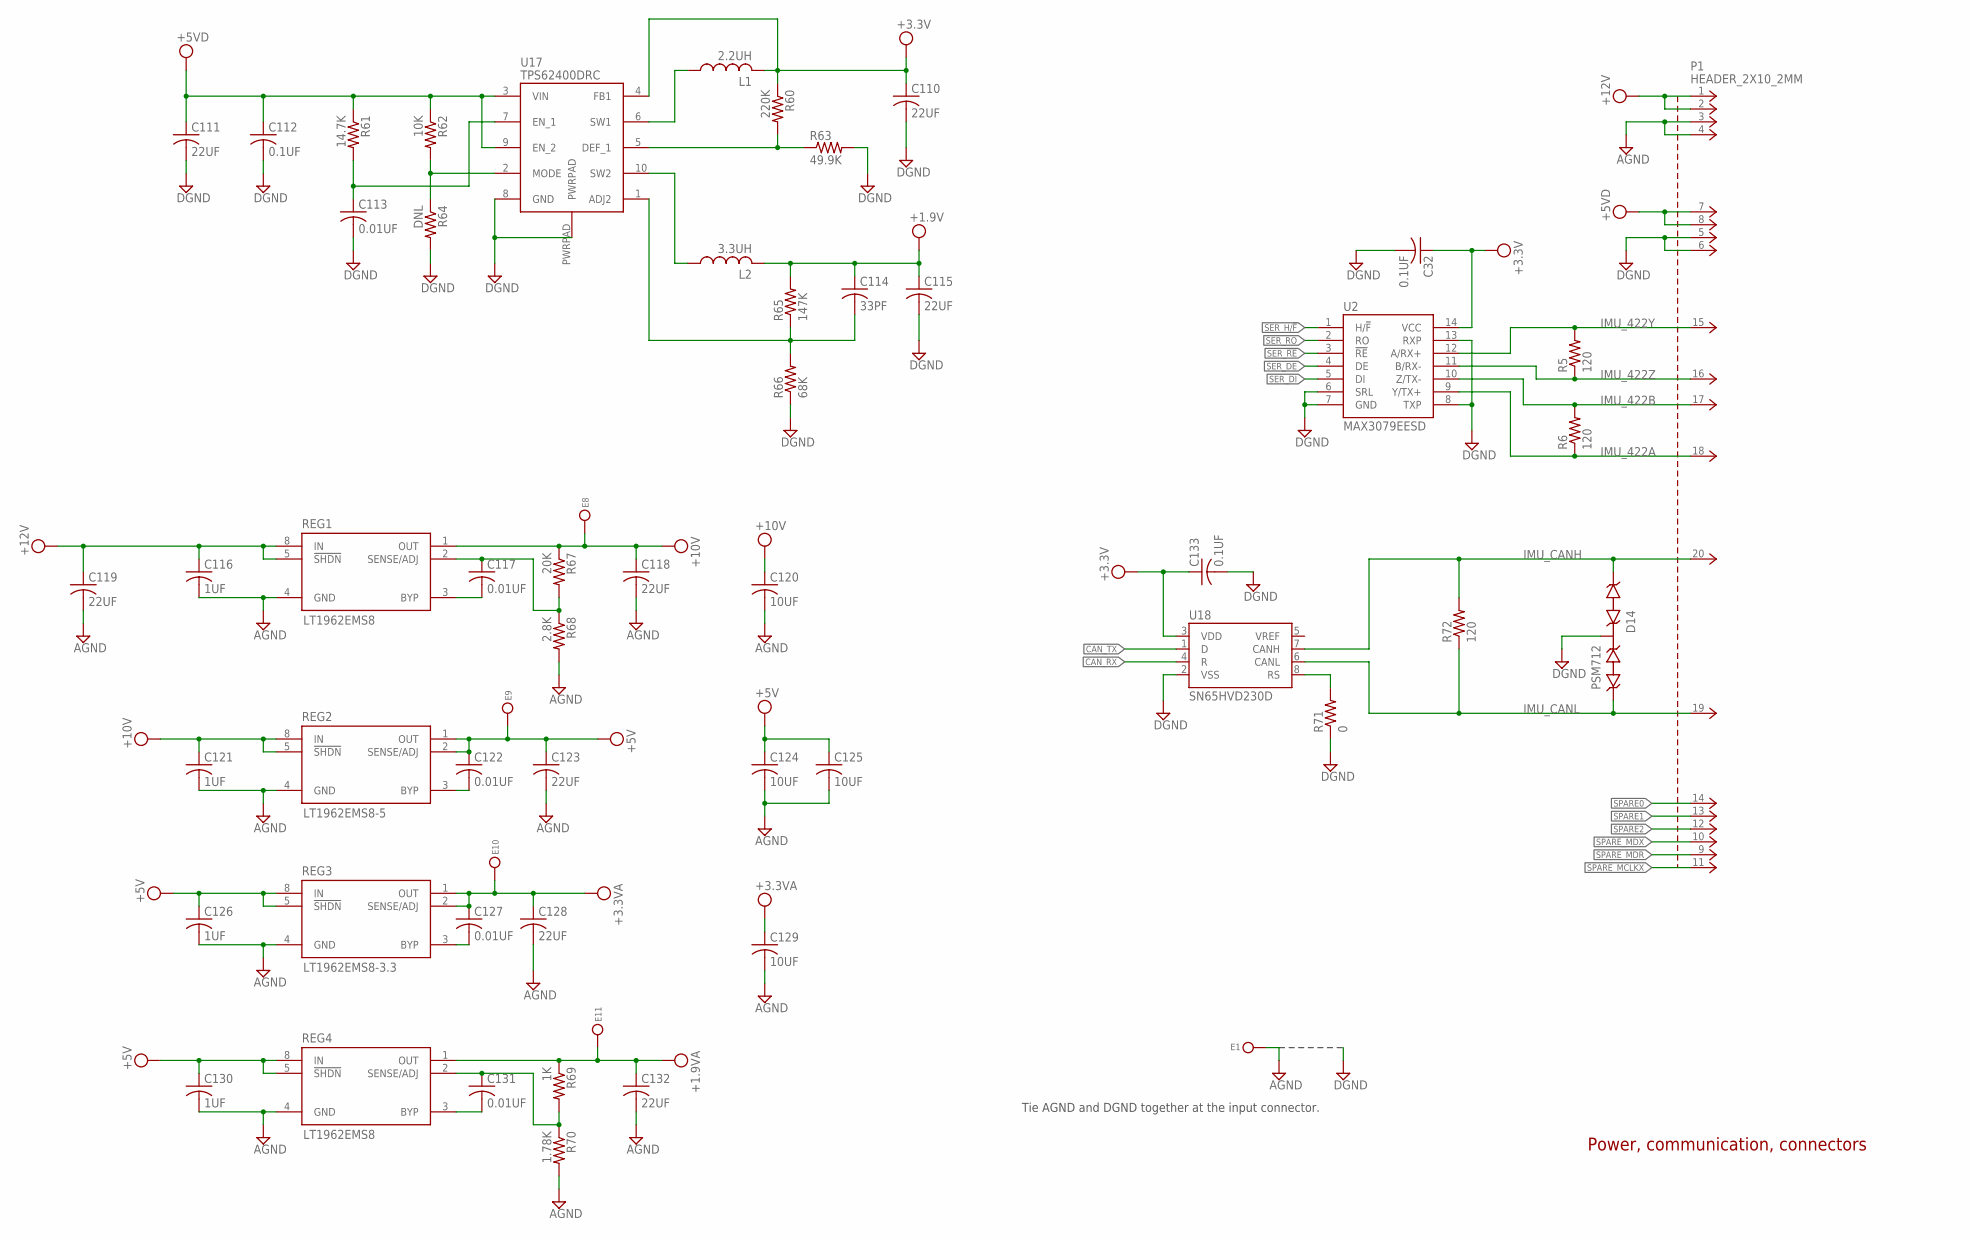
[picture p7: schematic imu_v2.sch, sheet 4]

Parts:
C32, C112, C133: 0.1UF; C0603K
C110, C111, C115, C118, C119, C123, C128, C132: 22UF; C1210K
C113, C117, C122, C127, C131: 0.01UF; C0603K
C114: 33PF; C0603K
C116, C121, C126, C130: 1UF; C0603K
C120, C124, C125, C129: 10UF; C1206K
D14: PSM712; SOT23
E1: 5015_TESTCLIP
E8, E9, E10, E11: TP30
L1: 2.2UH; VLF3010A
L2: 3.3UH; VLF3010A
P1: HEADER_2X10_2MM
R5, R6, R72: 120; R0603
R60: 220K; R0603
R61: 14.7K; R0603
R62: 10K; R0603
R63: 49.9K; R0603
R64: DNL; R0603
R65: 147K; R0603
R66: 68K; R0603
R67: 20K; R0603
R68: 2.8K; R0603
R69: 1K; R0603
R70: 1.78K; R0603
R71: 0; R0603
REG1, REG4: LT1962EMS8; MSOP8
REG2: LT1962EMS8-5; MSOP8
REG3: LT1962EMS8-3.3; MSOP8
U2: MAX3079EESD; SOIC14-NARROW
U17: TPS62400DRC; QFN10
U18: SN65HVD230D; SO08

Connections:
+1.9V: C114.1, C115.1, L2.2, R65.2; also elsewhere on the board
+1.9VA: C132.1, E11.1, R69.1, REG4.1 (OUT); also elsewhere on the board
+3.3V: C32.1, C110.1, C133.1, L1.2, R60.1, U2.14 (VCC), U17.4 (FB1), U18.3 (VDD); also elsewhere on the board
+3.3VA: C127.1, C128.1, C129.1, E10.1, REG3.1 (OUT), REG3.2 (SENSE/ADJ); also elsewhere on the board
+5V: C122.1, C123.1, C124.1, C125.1, C126.1, C130.1, E9.1, REG2.1 (OUT), REG2.2 (SENSE/ADJ), REG3.5 (!SHDN), REG3.8 (IN), REG4.5 (!SHDN), REG4.8 (IN); also elsewhere on the board
+5VD: C111.1, C112.1, P1.7, P1.8, R61.1, R62.1, U17.3 (VIN), U17.9 (EN_2)
+10V: C118.1, C120.1, C121.1, E8.1, R67.1, REG1.1 (OUT), REG2.5 (!SHDN), REG2.8 (IN); also elsewhere on the board
+12V: C116.1, C119.1, P1.1, P1.2, REG1.5 (!SHDN), REG1.8 (IN)
AGND: C116.2, C118.2, C119.2, C120.2, C121.2, C123.2, C124.2, C125.2, C126.2, C128.2, C129.2, C130.2, C132.2, E1.1, P1.3, P1.4, R68.2, R70.2, REG1.4 (GND), REG2.4 (GND), REG3.4 (GND), REG4.4 (GND); also elsewhere on the board
CAN_RX: U18.4 (R); also elsewhere on the board
CAN_TX: U18.1 (D); also elsewhere on the board
DGND: C32.2, C110.2, C111.2, C112.2, C113.2, C115.2, C133.2, D14.3, P1.5, P1.6, R63.2, R64.2, R66.1, R71.1, U2.6 (SRL), U2.7 (GND), U2.8 (TXP), U2.13 (RXP), U17.8 (GND), U17.PWRPAD, U18.2 (VSS); also elsewhere on the board
IMU_422A: P1.18, R6.1, U2.9 (Y/TX+)
IMU_422B: P1.17, R6.2, U2.10 (Z/TX-)
IMU_422Y: P1.15, R5.2, U2.12 (A/RX+)
IMU_422Z: P1.16, R5.1, U2.11 (B/RX-)
IMU_CANH: D14.1, P1.20, R72.2, U18.7 (CANH)
IMU_CANL: D14.2, P1.19, R72.1, U18.6 (CANL)
unnamed: R71.2, U18.8 (RS)
unnamed: C122.2, REG2.3 (BYP)
unnamed: C127.2, REG3.3 (BYP)
unnamed: C117.2, REG1.3 (BYP)
unnamed: C117.1, R67.2, R68.1, REG1.2 (SENSE/ADJ)
unnamed: C131.2, REG4.3 (BYP)
unnamed: C131.1, R69.2, R70.1, REG4.2 (SENSE/ADJ)
unnamed: L1.1, U17.6 (SW1)
unnamed: L2.1, U17.10 (SW2)
unnamed: R60.2, R63.1, U17.5 (DEF_1)
unnamed: R62.2, R64.1, U17.2 (MODE)
unnamed: C114.2, R65.1, R66.2, U17.1 (ADJ2)
unnamed: C113.1, R61.2, U17.7 (EN_1)
SER_!RE: U2.3 (!RE); also elsewhere on the board
SER_DE: U2.4 (DE); also elsewhere on the board
SER_DI: U2.5 (DI); also elsewhere on the board
SER_H/!F: U2.1 (H/!F); also elsewhere on the board
SER_RO: U2.2 (RO); also elsewhere on the board
SPARE0: P1.14; also elsewhere on the board
SPARE1: P1.13; also elsewhere on the board
SPARE2: P1.12; also elsewhere on the board
SPARE_MCLKX: P1.11; also elsewhere on the board
SPARE_MDR: P1.9; also elsewhere on the board
SPARE_MDX: P1.10; also elsewhere on the board

Notes on the sheet:
Power, communication, connectors
Tie AGND and DGND together at the input connector.

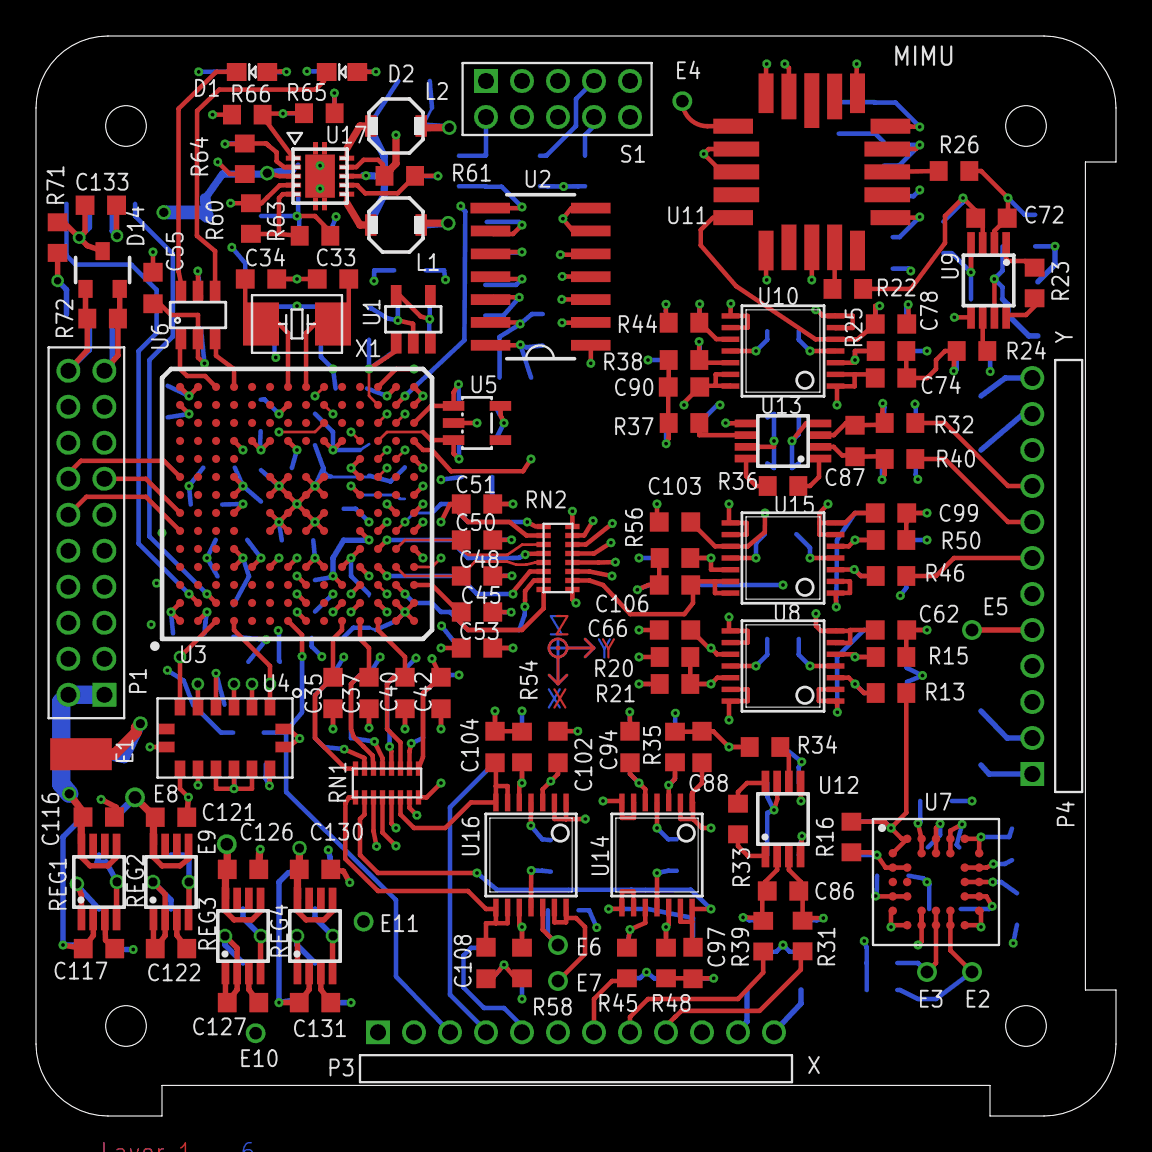
[picture p8: board imu_v2.brd from above]

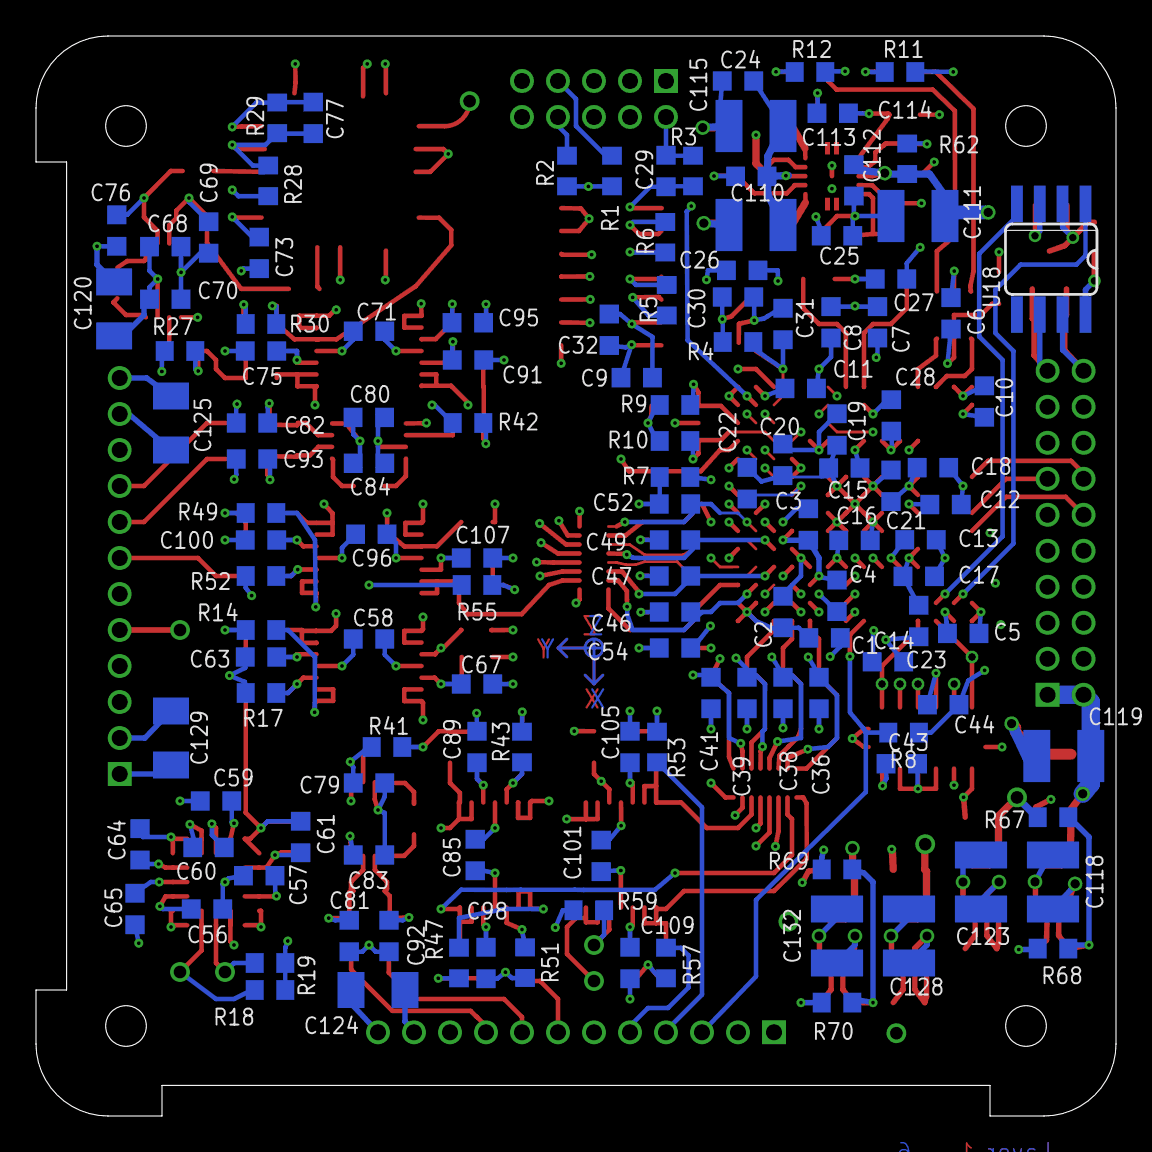
[picture p9: board imu_v2.brd from below]

Board: 6 copper layers, 60.0 x 60.0 mm, 250 parts (132 on the bottom side), 172 nets.
