google/zimu/hardware/IMU_v2_side/imu_v2_side.brd

## EAGLE design hardware/IMU_v2_side/imu_v2_side.brd (2013-10-02)

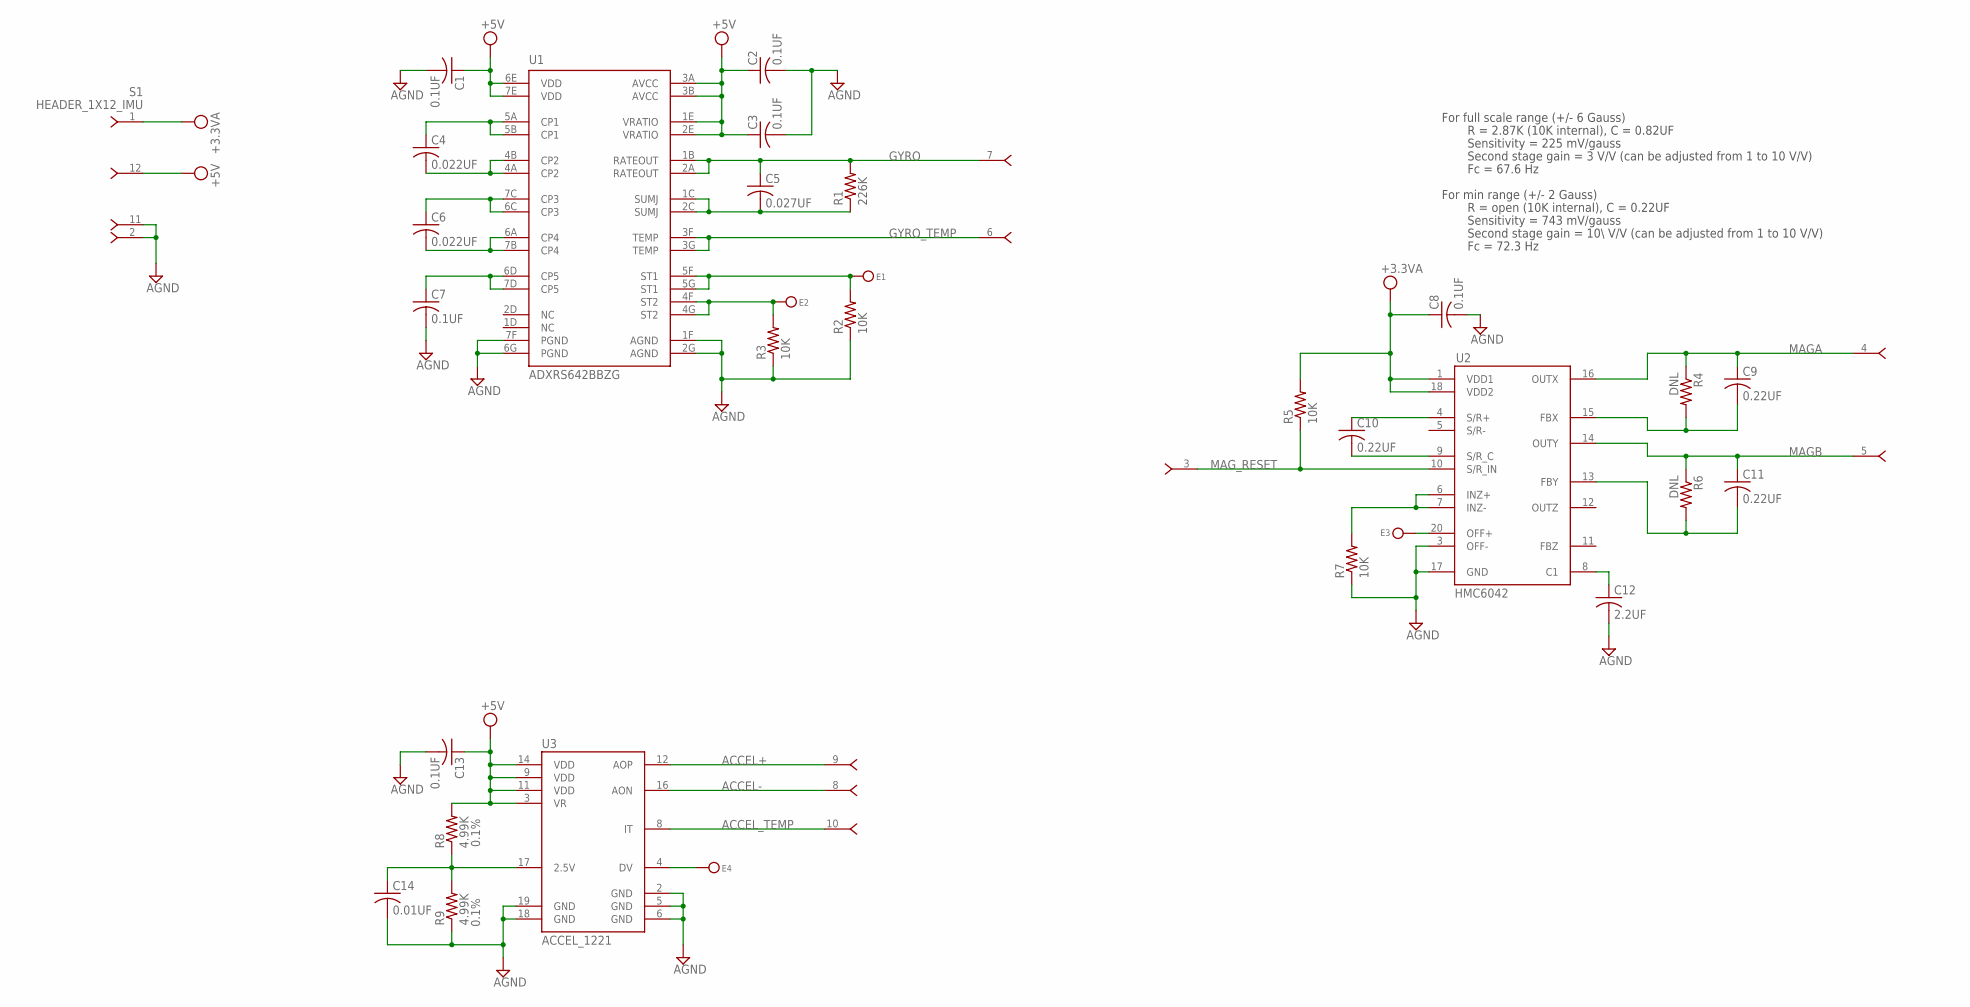
[picture p10: schematic imu_v2_side.sch]

Parts:
C1, C2, C3, C7, C8, C13: 0.1UF; C0603K
C4, C6: 0.022UF; C0603K
C5: 0.027UF; C0603K
C9, C10, C11: 0.22UF; C0603K
C12: 2.2UF; C0603K
C14: 0.01UF; C0603K
E1, E2, E3, E4: TP30
R1: 226K; R0603
R2, R3, R5, R7: 10K; R0603
R4, R6: DNL; R0603
R8, R9: 4.99K; R0603
S1: HEADER_1X12_IMU; HEADER_1X12_2MM_TH
U1: ADXRS642BBZG; ADXRS_CBGA32
U2: HMC6042; HMC6042_LPCC
U3: ACCEL_1221; 1221_LCC

Connections:
+3.3VA: C8.1, R5.2, S1.1, U2.1 (VDD1), U2.18 (VDD2)
+5V: C1.1, C2.1, C3.1, C13.1, R8.2, S1.12 (1), U1.1E (VRATIO), U1.2E (VRATIO), U1.3A (AVCC), U1.3B (AVCC), U1.6E (VDD), U1.7E (VDD), U3.3 (VR), U3.9 (VDD), U3.11 (VDD), U3.14 (VDD)
ACCEL+: S1.9 (1), U3.12 (AOP)
ACCEL-: S1.8 (1), U3.16 (AON)
ACCEL_TEMP: S1.10 (1), U3.8 (IT)
AGND: C1.2, C2.2, C3.2, C7.2, C8.2, C12.2, C13.2, C14.2, R2.1, R3.1, R7.1, R9.1, S1.2 (1), S1.11 (1), U1.1F (AGND), U1.2G (AGND), U1.6G (PGND), U1.7F (PGND), U2.3 (OFF-), U2.17 (GND), U3.2 (GND), U3.5 (GND), U3.6 (GND), U3.18 (GND), U3.19 (GND)
GYRO: C5.1, R1.2, S1.7 (1), U1.1B (RATEOUT), U1.2A (RATEOUT)
GYRO_ST1: E1.1, R2.2, U1.5F (ST1), U1.5G (ST1)
GYRO_ST2: E2.1, R3.2, U1.4F (ST2), U1.4G (ST2)
GYRO_TEMP: S1.6 (1), U1.3F (TEMP), U1.3G (TEMP)
MAGA: C9.1, R4.1, S1.4 (1), U2.16 (OUTX)
MAGB: C11.1, R6.1, S1.5 (1), U2.14 (OUTY)
MAG_RESET: R5.1, S1.3 (1), U2.10 (S/R_IN)
unnamed: C4.1, U1.5A (CP1), U1.5B (CP1)
unnamed: C4.2, U1.4A (CP2), U1.4B (CP2)
unnamed: C6.1, U1.6C (CP3), U1.7C (CP3)
unnamed: C6.2, U1.6A (CP4), U1.7B (CP4)
unnamed: C7.1, U1.6D (CP5), U1.7D (CP5)
unnamed: C14.1, R8.1, R9.2, U3.17 (2.5V)
unnamed: C5.2, R1.1, U1.1C (SUMJ), U1.2C (SUMJ)
unnamed: E4.1, U3.4 (DV)
unnamed: E3.1, U2.20 (OFF+)
unnamed: R7.2, U2.6 (INZ+), U2.7 (INZ-)
unnamed: C10.1, U2.4 (S/R+)
unnamed: C10.2, U2.9 (S/R_C)
unnamed: C12.1, U2.8 (C1)
unnamed: C9.2, R4.2, U2.15 (FBX)
unnamed: C11.2, R6.2, U2.13 (FBY)

Notes on the sheet:
Second stage gain = 3 V/V (can be adjusted from 1 to 10 V/V)
Sensitivity = 225 mV/gauss
Fc = 67.6 Hz
For full scale range (+/- 6 Gauss)
For min range (+/- 2 Gauss)
R = 2.87K (10K internal), C = 0.82UF
Second stage gain = 10\ V/V (can be adjusted from 1 to 10 V/V)
Sensitivity = 743 mV/gauss
Fc = 72.3 Hz
R = open (10K internal), C = 0.22UF

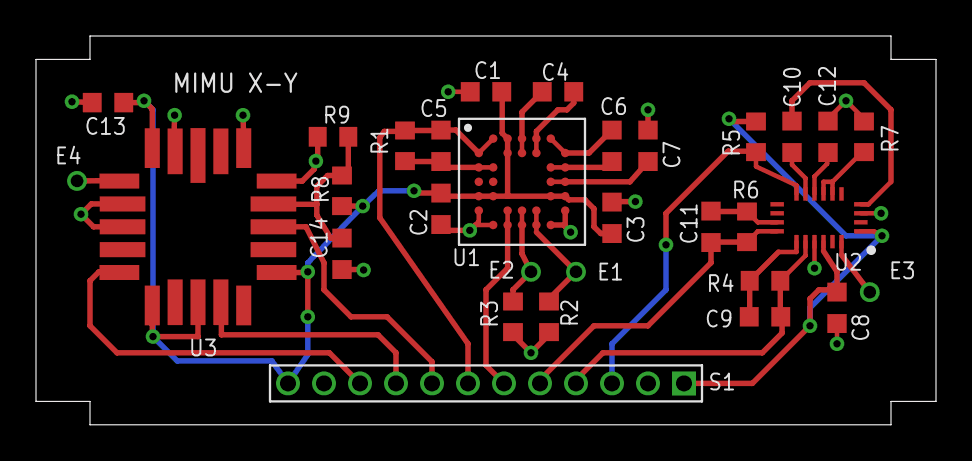
[picture p11: board imu_v2_side.brd from above]

Board: 2 copper layers, 50.0 x 21.6 mm, 31 parts (0 on the bottom side), 28 nets.
